hsetlik/ESP808/Schematic/Clap.kicad_sch

## KiCad design Schematic/Clap.kicad_sch (2023-09-09)

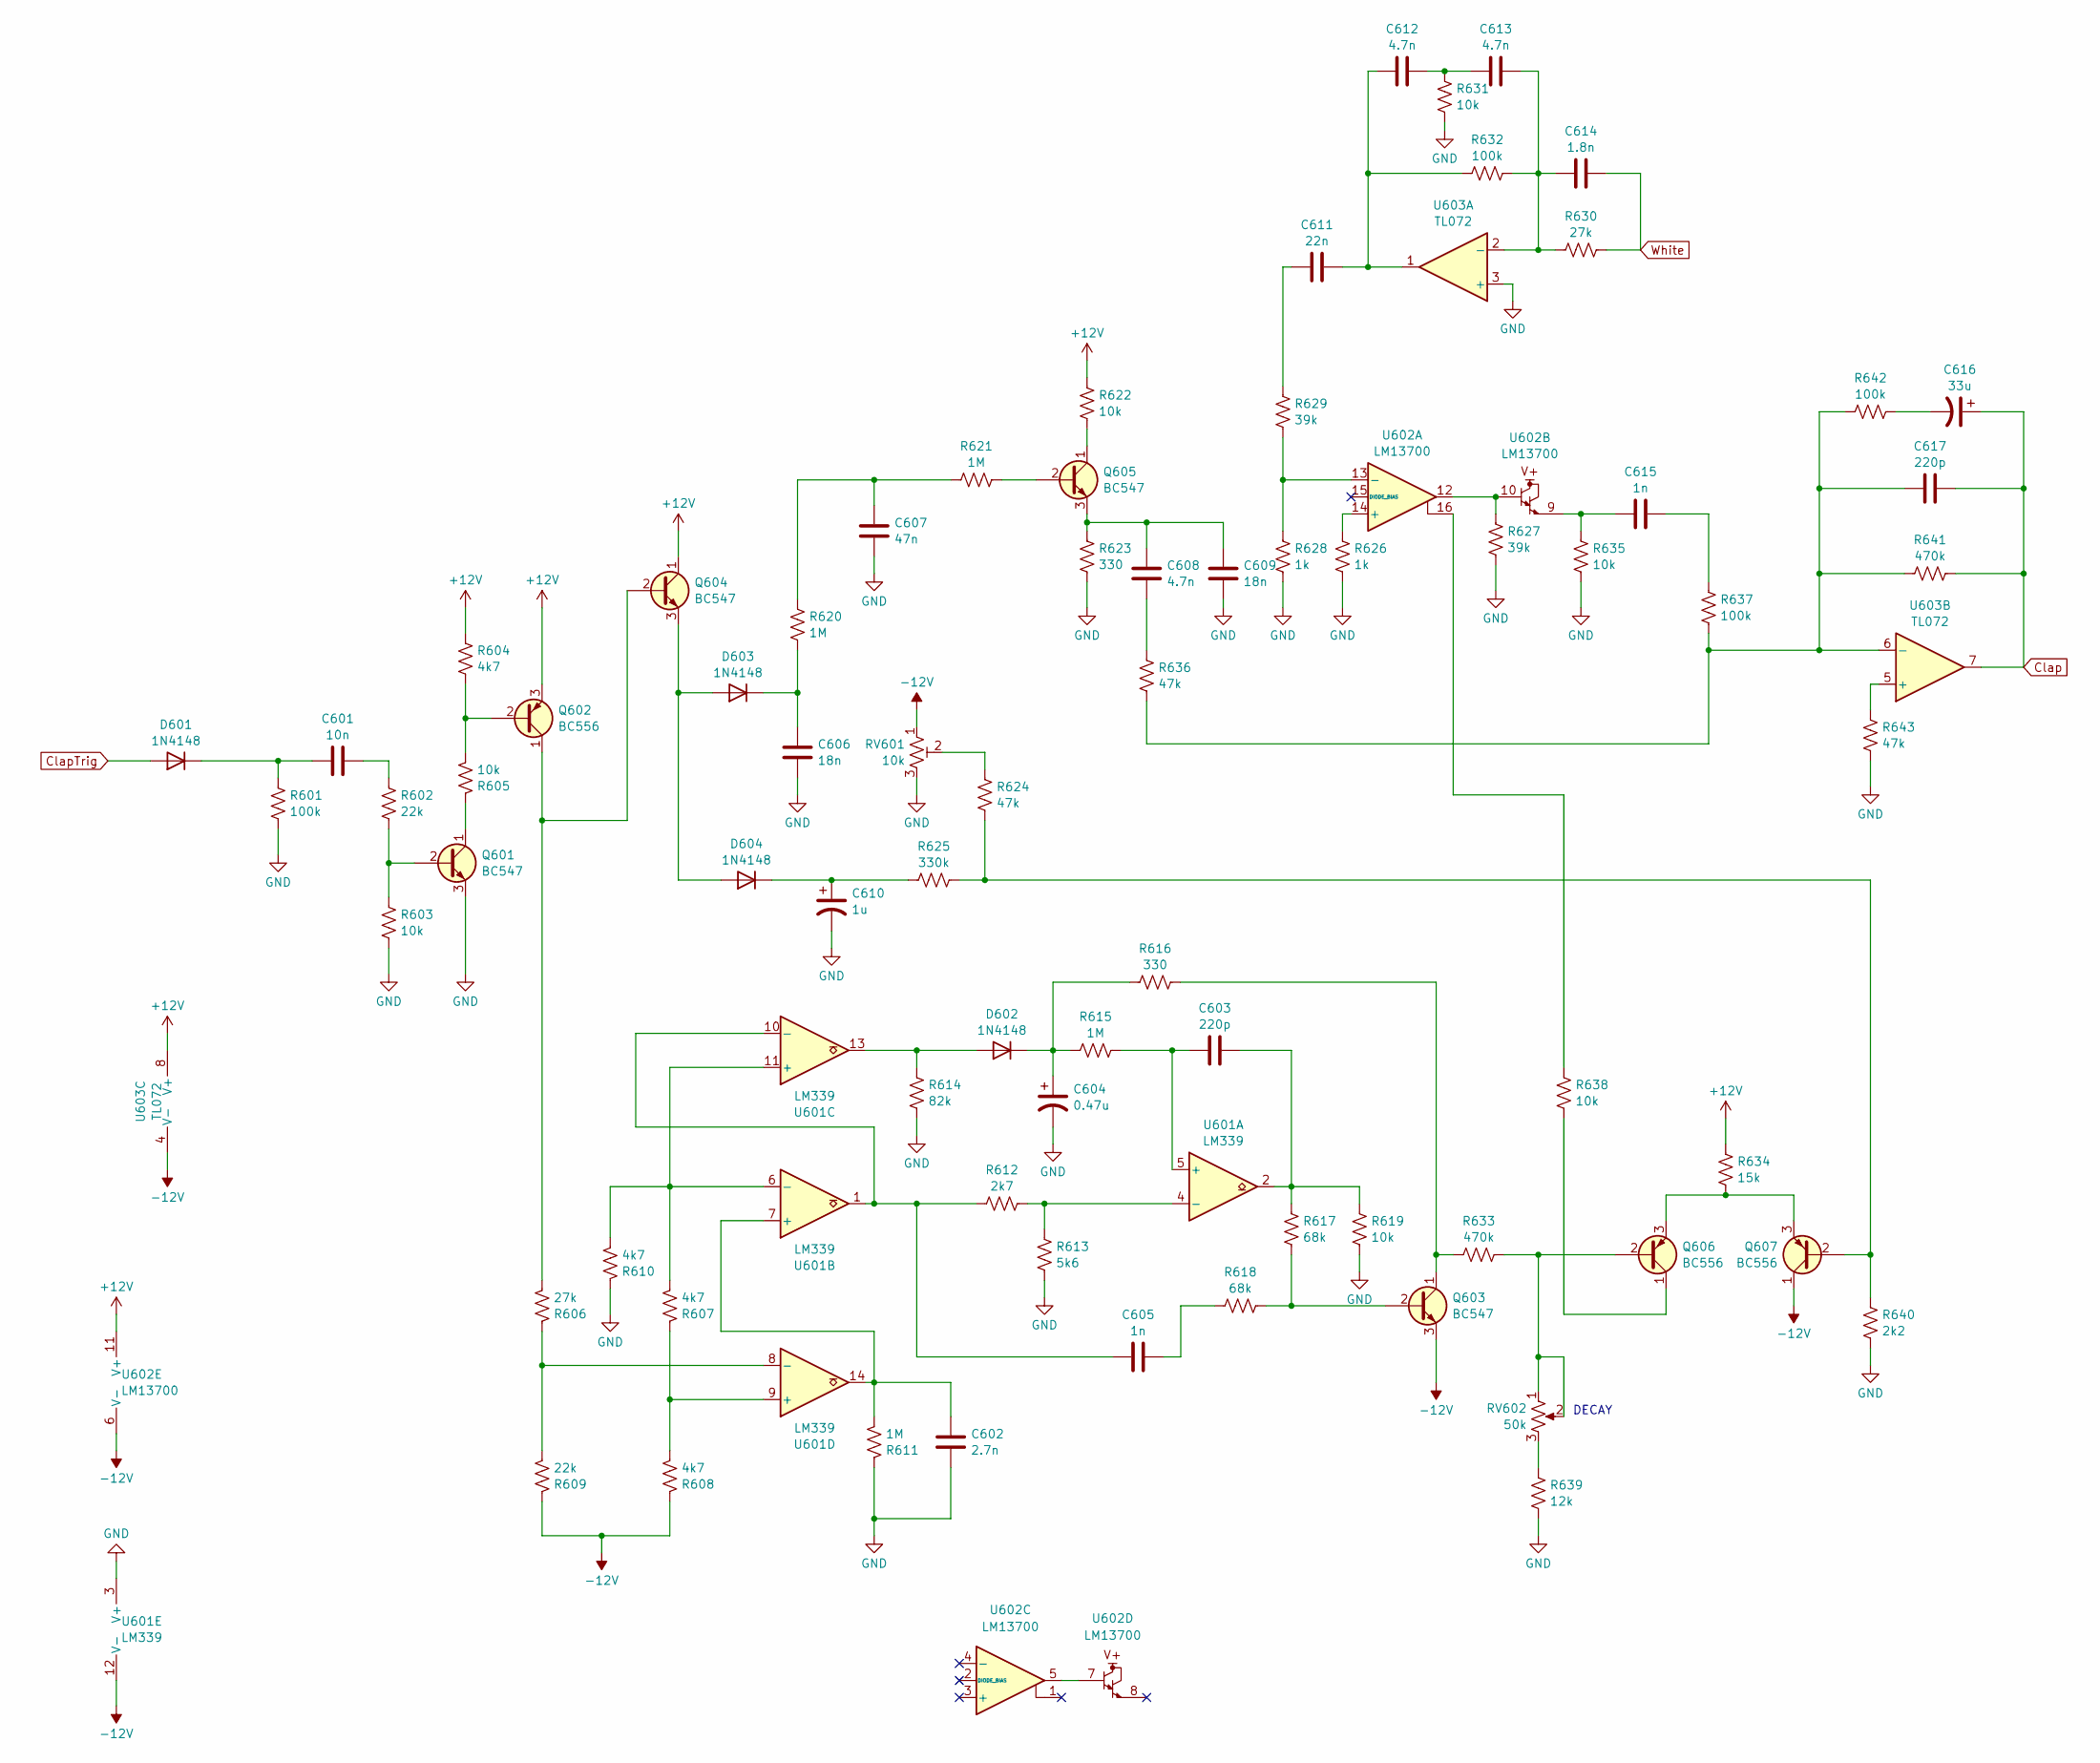
[picture p1: schematic Clap.kicad_sch]

Parts:
C601: 10n; C_Disc_D4.7mm_W2.5mm_P5.00mm
C602: 2.7n; C_Disc_D4.7mm_W2.5mm_P5.00mm
C603, C617: 220p; C_Disc_D4.7mm_W2.5mm_P5.00mm
C604: 0.47u; CP_Radial_D5.0mm_P2.00mm
C605, C615: 1n; C_Disc_D4.7mm_W2.5mm_P5.00mm
C606, C609: 18n; C_Disc_D4.7mm_W2.5mm_P5.00mm
C607: 47n; C_Disc_D4.7mm_W2.5mm_P5.00mm
C608, C612, C613: 4.7n; C_Disc_D4.7mm_W2.5mm_P5.00mm
C610: 1u; CP_Radial_D5.0mm_P2.00mm
C611: 22n; C_Disc_D4.7mm_W2.5mm_P5.00mm
C614: 1.8n; C_Disc_D4.7mm_W2.5mm_P5.00mm
C616: 33u; CP_Radial_D6.3mm_P2.50mm
D601, D602, D603, D604: 1N4148; D_DO-35_SOD27_P7.62mm_Horizontal
Q601, Q603, Q604, Q605: BC547; TO-92L_HandSolder
Q602, Q606, Q607: BC556; TO-92L_HandSolder
R601, R632, R637, R642: 100k; R_Axial_DIN0207_L6.3mm_D2.5mm_P7.62mm_Horizontal
R602, R609: 22k; R_Axial_DIN0207_L6.3mm_D2.5mm_P7.62mm_Horizontal
R603, R605, R619, R622, R631, R635, R638: 10k; R_Axial_DIN0207_L6.3mm_D2.5mm_P7.62mm_Horizontal
R604, R607, R608, R610: 4k7; R_Axial_DIN0207_L6.3mm_D2.5mm_P7.62mm_Horizontal
R606, R630: 27k; R_Axial_DIN0207_L6.3mm_D2.5mm_P7.62mm_Horizontal
R611, R615, R620, R621: 1M; R_Axial_DIN0207_L6.3mm_D2.5mm_P7.62mm_Horizontal
R612: 2k7; R_Axial_DIN0207_L6.3mm_D2.5mm_P7.62mm_Horizontal
R613: 5k6; R_Axial_DIN0207_L6.3mm_D2.5mm_P7.62mm_Horizontal
R614: 82k; R_Axial_DIN0207_L6.3mm_D2.5mm_P7.62mm_Horizontal
R616, R623: 330; R_Axial_DIN0207_L6.3mm_D2.5mm_P7.62mm_Horizontal
R617, R618: 68k; R_Axial_DIN0207_L6.3mm_D2.5mm_P7.62mm_Horizontal
R624, R636, R643: 47k; R_Axial_DIN0207_L6.3mm_D2.5mm_P7.62mm_Horizontal
R625: 330k; R_Axial_DIN0207_L6.3mm_D2.5mm_P7.62mm_Horizontal
R626, R628: 1k; R_Axial_DIN0207_L6.3mm_D2.5mm_P7.62mm_Horizontal
R627, R629: 39k; R_Axial_DIN0207_L6.3mm_D2.5mm_P7.62mm_Horizontal
R633, R641: 470k; R_Axial_DIN0207_L6.3mm_D2.5mm_P7.62mm_Horizontal
R634: 15k; R_Axial_DIN0207_L6.3mm_D2.5mm_P7.62mm_Horizontal
R639: 12k; R_Axial_DIN0207_L6.3mm_D2.5mm_P7.62mm_Horizontal
R640: 2k2; R_Axial_DIN0207_L6.3mm_D2.5mm_P7.62mm_Horizontal
RV601: 10k; Potentiometer_Piher_PT-6-V_Vertical
RV602: 50k; PinHeader_1x03_P2.54mm_Vertical
U601: LM339; DIP-14_W7.62mm
U602: LM13700; DIP-16_W7.62mm
U603: TL072; DIP-8_W7.62mm

Connections:
+12V: Q602.3 (E), Q604.1 (C), R604.1, R622.1, R634.2, U602.11 (V+), U603.8 (V+)
-12V: Q603.3 (E), Q607.1 (C), R608.1, R609.1, RV601.1, U601.12 (V-), U602.6 (V-), U603.4 (V-)
Clap: C616.1, C617.2, R641.2, U603.7
ClapTrig: D601.2 (A)
GND: C602.2, C604.2, C606.2, C607.2, C609.2, C610.2, Q601.3 (E), R601.2, R603.2, R610.1, R611.1, R613.1, R614.1, R619.1, R623.2, R626.2, R627.2, R628.2, R631.2, R635.2, R639.1, R640.1, R643.2, RV601.3, U601.3 (V+), U603.3 (+)
unnamed: C601.1, D601.1 (K), R601.1
unnamed: C601.2, R602.1
unnamed: C602.1, R611.2, U601.7 (+), U601.14
unnamed: C603.1, R617.2, R619.2, U601.2
unnamed: C603.2, R615.1, U601.5 (+)
unnamed: C604.1, D602.1 (K), R615.2, R616.2
unnamed: C605.1, R618.2
unnamed: C605.2, R612.1, U601.1, U601.10 (-)
unnamed: C606.1, D603.1 (K), R620.2
unnamed: C607.1, R620.1, R621.1
unnamed: C608.1, C609.1, Q605.3 (E), R623.1
unnamed: C608.2, R636.1
unnamed: C610.1, D604.1 (K), R625.1
unnamed: C611.1, R629.1
unnamed: C611.2, C612.1, R632.1, U603.1
unnamed: C612.2, C613.1, R631.1
unnamed: C613.2, C614.1, R630.1, R632.2, U603.2 (-)
unnamed: C615.1, R635.1, U602.9
unnamed: C615.2, R637.1
unnamed: C616.2, R642.2
unnamed: C617.1, R636.2, R637.2, R641.1, R642.1, U603.6 (-)
unnamed: D602.2 (A), R614.2, U601.13
unnamed: D603.2 (A), D604.2 (A), Q604.3 (E)
unnamed: Q601.1 (C), R605.1
unnamed: Q601.2 (B), R602.2, R603.1
unnamed: Q602.1 (C), Q604.2 (B), R606.2
unnamed: Q602.2 (B), R604.2, R605.2
unnamed: Q603.1 (C), R616.1, R633.2
unnamed: Q603.2 (B), R617.1, R618.1
unnamed: Q605.1 (C), R622.2
unnamed: Q605.2 (B), R621.2
unnamed: Q606.1 (C), R638.2
unnamed: Q606.2 (B), R633.1, RV602.1, RV602.2
unnamed: Q606.3 (E), Q607.3 (E), R634.1
unnamed: Q607.2 (B), R624.2, R625.2, R640.2
unnamed: R606.1, R609.2, U601.8 (-)
unnamed: R607.1, R608.2, U601.9 (+)
unnamed: R607.2, R610.2, U601.6 (-), U601.11 (+)
unnamed: R612.2, R613.2, U601.4 (-)
unnamed: R624.1, RV601.2
unnamed: R626.1, U602.14 (+)
unnamed: R627.1, U602.10, U602.12
unnamed: R628.1, R629.2, U602.13 (-)
unnamed: R638.1, U602.16
unnamed: R639.2, RV602.3
unnamed: R643.1, U603.5 (+)
unnamed: U602.5, U602.7
White: C614.2, R630.2

Notes on the sheet:
DECAY
