hsetlik/ESP808/Schematic/Clave.kicad_sch

## KiCad design Schematic/Clave.kicad_sch (2023-09-09)

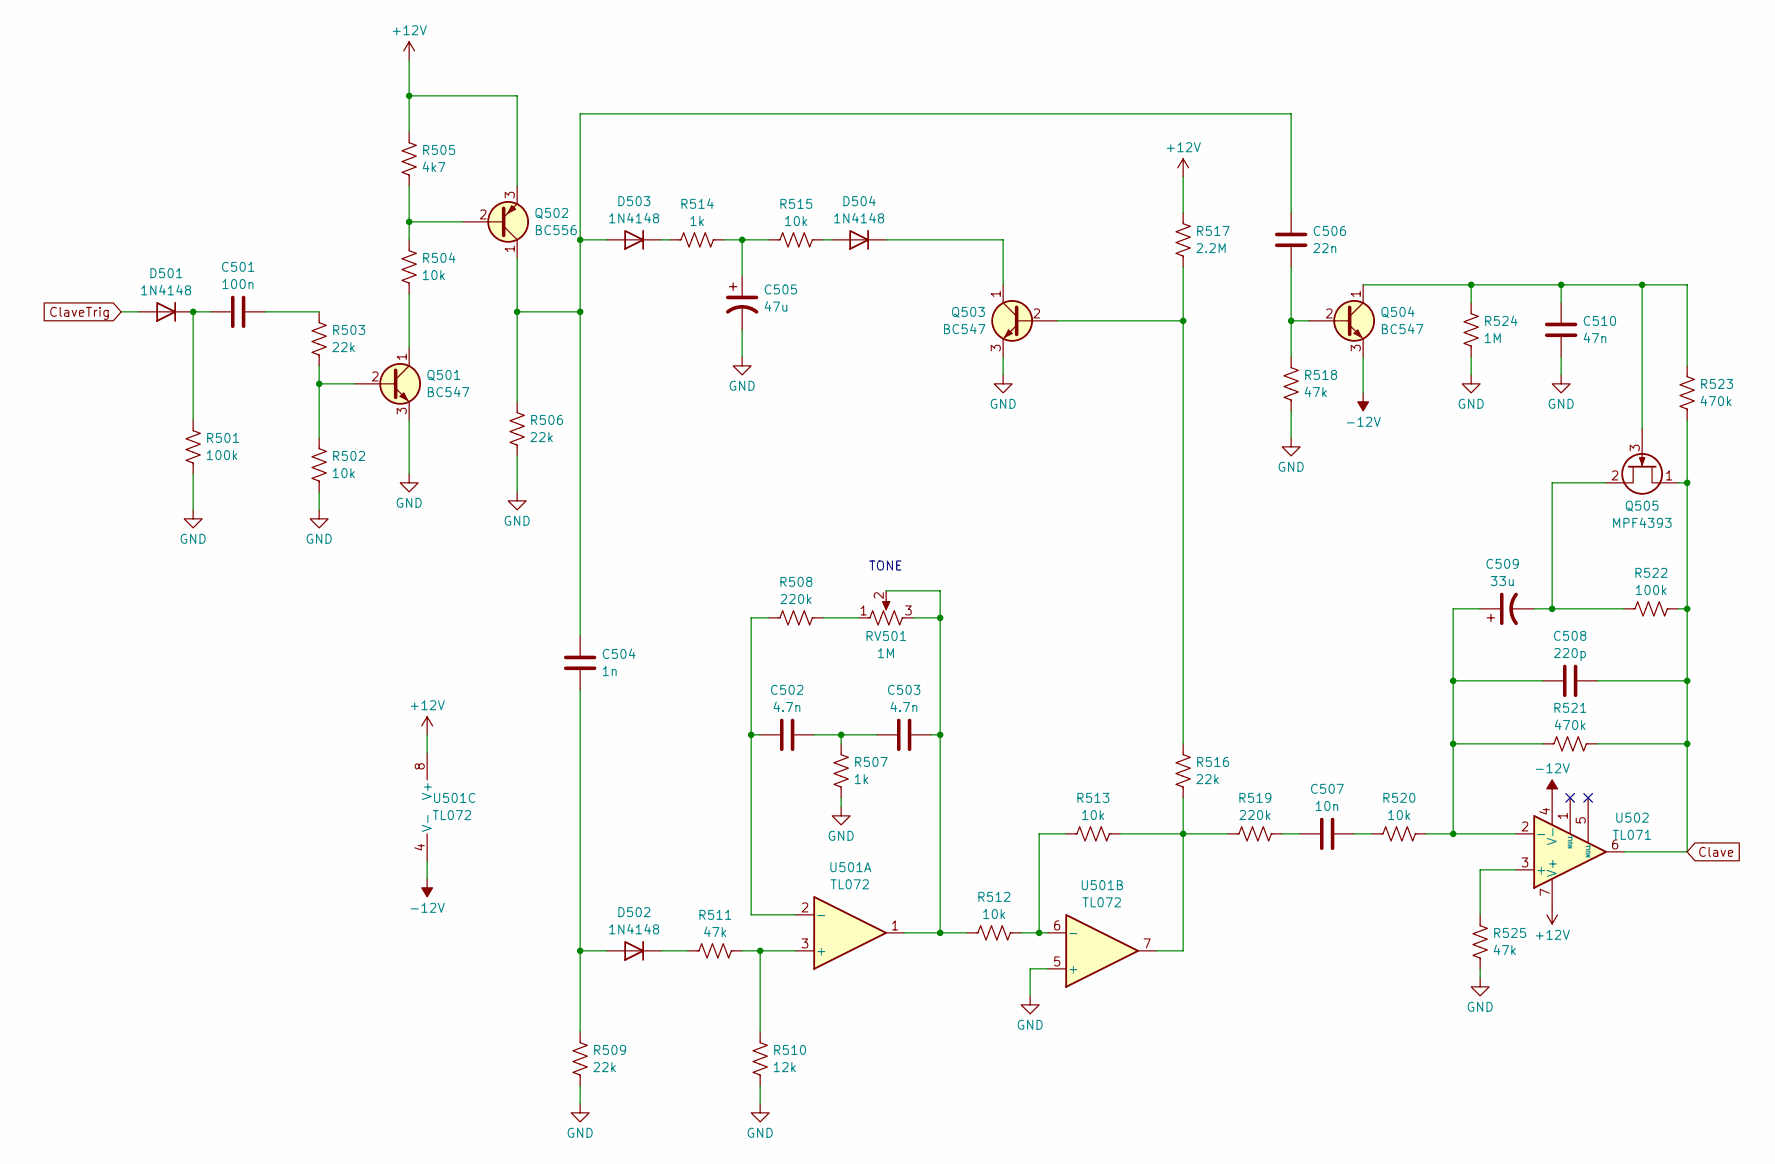
[picture p2: schematic Clave.kicad_sch]

Parts:
C501: 100n; C_Disc_D4.7mm_W2.5mm_P5.00mm
C502, C503: 4.7n; C_Disc_D4.7mm_W2.5mm_P5.00mm
C504: 1n; C_Disc_D4.7mm_W2.5mm_P5.00mm
C505: 47u; CP_Radial_D6.3mm_P2.50mm
C506: 22n; C_Disc_D4.7mm_W2.5mm_P5.00mm
C507: 10n; C_Disc_D4.7mm_W2.5mm_P5.00mm
C508: 220p; C_Disc_D4.7mm_W2.5mm_P5.00mm
C509: 33u; CP_Radial_D6.3mm_P2.50mm
C510: 47n; C_Disc_D4.7mm_W2.5mm_P5.00mm
D501, D502, D503, D504: 1N4148; D_DO-35_SOD27_P7.62mm_Horizontal
Q501, Q503, Q504: BC547; TO-92L_HandSolder
Q502: BC556; TO-92L_HandSolder
Q505: MPF4393; TO-92L_HandSolder
R501, R522: 100k; R_Axial_DIN0207_L6.3mm_D2.5mm_P7.62mm_Horizontal
R502, R504, R512, R513, R515, R520: 10k; R_Axial_DIN0207_L6.3mm_D2.5mm_P7.62mm_Horizontal
R503, R506, R509, R516: 22k; R_Axial_DIN0207_L6.3mm_D2.5mm_P7.62mm_Horizontal
R505: 4k7; R_Axial_DIN0207_L6.3mm_D2.5mm_P7.62mm_Horizontal
R507, R514: 1k; R_Axial_DIN0207_L6.3mm_D2.5mm_P7.62mm_Horizontal
R508, R519: 220k; R_Axial_DIN0207_L6.3mm_D2.5mm_P7.62mm_Horizontal
R510: 12k; R_Axial_DIN0207_L6.3mm_D2.5mm_P7.62mm_Horizontal
R511, R518, R525: 47k; R_Axial_DIN0207_L6.3mm_D2.5mm_P7.62mm_Horizontal
R517: 2.2M; R_Axial_DIN0207_L6.3mm_D2.5mm_P7.62mm_Horizontal
R521, R523: 470k; R_Axial_DIN0207_L6.3mm_D2.5mm_P7.62mm_Horizontal
R524: 1M; R_Axial_DIN0207_L6.3mm_D2.5mm_P7.62mm_Horizontal
RV501: 1M; PinHeader_1x03_P2.54mm_Vertical
U501: TL072; DIP-8_W7.62mm
U502: TL071; DIP-8_W7.62mm

Connections:
+12V: Q502.3 (E), R505.1, R517.2, U501.8 (V+), U502.7 (V+)
-12V: Q504.3 (E), U501.4 (V-), U502.4 (V-)
Clave: C508.2, Q505.1 (D), R521.2, R522.2, R523.2, U502.6
ClaveTrig: D501.2 (A)
GND: C505.2, C510.2, Q501.3 (E), Q503.3 (E), R501.2, R502.2, R506.2, R507.2, R509.1, R510.1, R518.1, R524.2, R525.1, U501.5 (+)
unnamed: C501.1, D501.1 (K), R501.1
unnamed: C501.2, R503.1
unnamed: C502.1, R508.1, U501.2 (-)
unnamed: C502.2, C503.1, R507.1
unnamed: C503.2, R512.1, RV501.2, RV501.3, U501.1
unnamed: C504.1, C506.1, D503.2 (A), Q502.1 (C), R506.1
unnamed: C504.2, D502.2 (A), R509.2
unnamed: C505.1, R514.2, R515.1
unnamed: C506.2, Q504.2 (B), R518.2
unnamed: C507.1, R519.2
unnamed: C507.2, R520.1
unnamed: C508.1, C509.1, R520.2, R521.1, U502.2 (-)
unnamed: C509.2, Q505.2 (S), R522.1
unnamed: C510.1, Q504.1 (C), Q505.3 (G), R523.1, R524.1
unnamed: D502.1 (K), R511.2
unnamed: D503.1 (K), R514.1
unnamed: D504.1 (K), Q503.1 (C)
unnamed: D504.2 (A), R515.2
unnamed: Q501.1 (C), R504.2
unnamed: Q501.2 (B), R502.1, R503.2
unnamed: Q502.2 (B), R504.1, R505.2
unnamed: Q503.2 (B), R516.2, R517.1
unnamed: R508.2, RV501.1
unnamed: R510.2, R511.1, U501.3 (+)
unnamed: R512.2, R513.1, U501.6 (-)
unnamed: R513.2, R516.1, R519.1, U501.7
unnamed: R525.2, U502.3 (+)

Notes on the sheet:
TONE
