hsetlik/ESP808/Schematic/Digital.kicad_sch

## KiCad design Schematic/Digital.kicad_sch (2023-11-16)

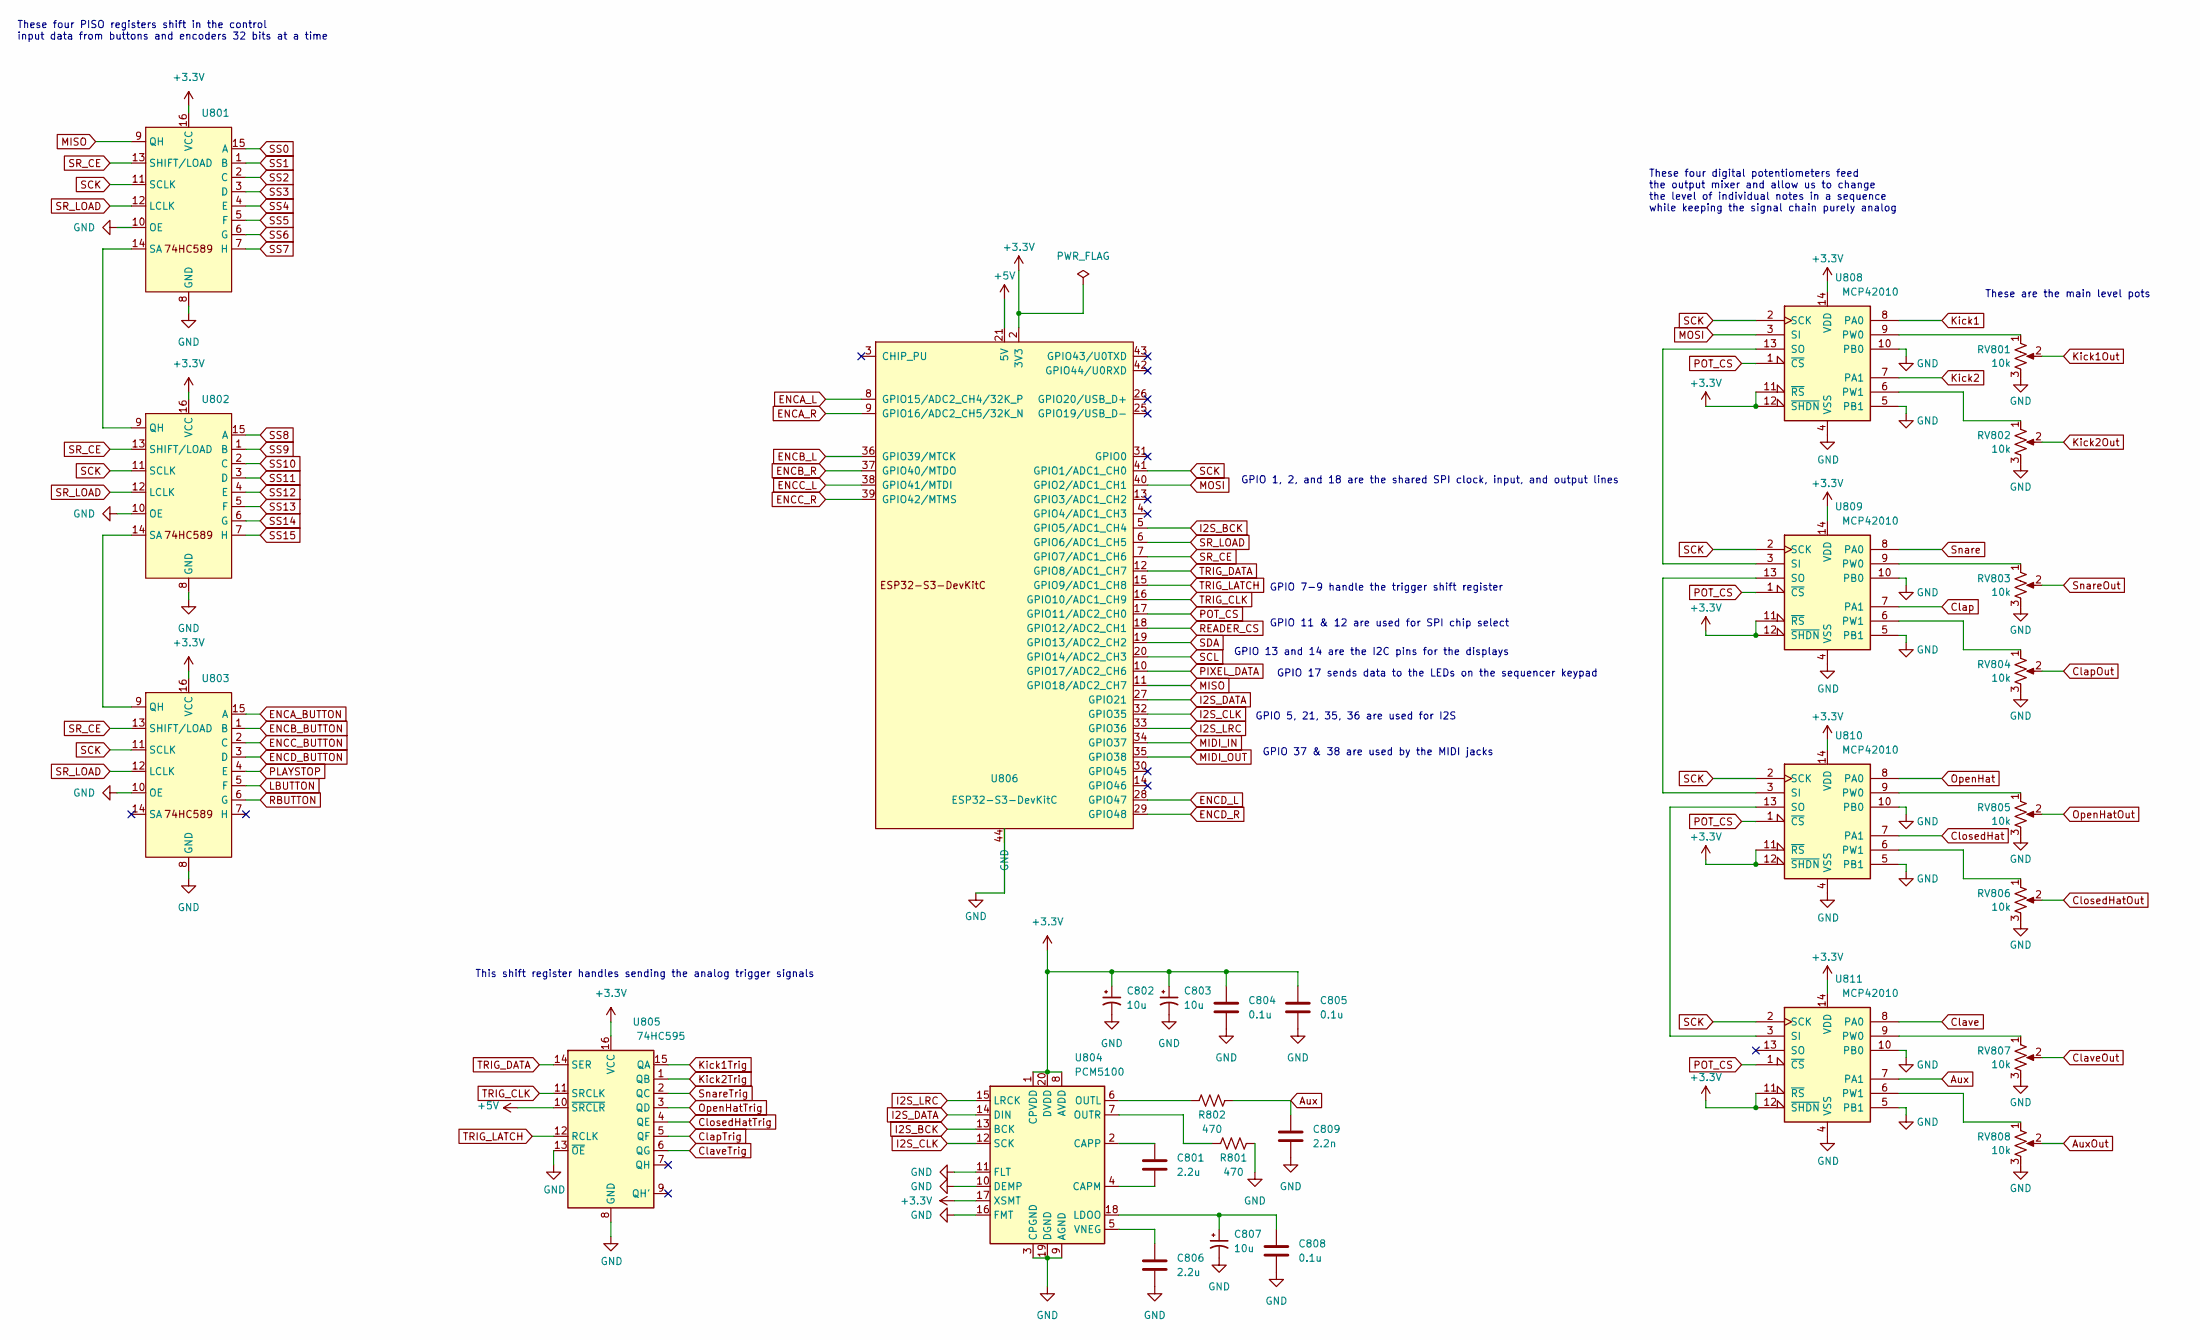
[picture p3: schematic Digital.kicad_sch]

Parts:
C801, C806: 2.2u; C_Disc_D4.7mm_W2.5mm_P5.00mm
C802, C803, C807: 10u; CP_Radial_D5.0mm_P2.00mm
C804, C805, C808: 0.1u; C_Disc_D4.7mm_W2.5mm_P5.00mm
C809: 2.2n; C_Disc_D4.7mm_W2.5mm_P5.00mm
R801, R802: 470; R_Axial_DIN0207_L6.3mm_D2.5mm_P7.62mm_Horizontal
RV801, RV802, RV803, RV804, RV805, RV806, RV807, RV808: 10k; PinHeader_1x03_P2.54mm_Vertical
U801, U802, U803: SO-16_3.9x9.9mm_P1.27mm
U804: PCM5100; TSSOP-20_4.4x6.5mm_P0.65mm
U805: 74HC595; DIP-16_W7.62mm
U806: ESP32-S3-DevKitC
U808, U809, U810, U811: MCP42010; DIP-14_W7.62mm

Connections:
+3.3V: C802.1, C803.1, C804.1, C805.1, U801.16 (VCC), U802.16 (VCC), U803.16 (VCC), U804.1 (CPVDD), U804.8 (AVDD), U804.17 (XSMT), U804.20 (DVDD), U805.16 (VCC), U806.1 (3V3), U806.2 (3V3), U808.11 (~RS), U808.12 (~SHDN), U808.14 (VDD), U809.11 (~RS), U809.12 (~SHDN), U809.14 (VDD), U810.11 (~RS), U810.12 (~SHDN), U810.14 (VDD), U811.11 (~RS), U811.12 (~SHDN), U811.14 (VDD)
+5V: U805.10 (~SRCLR), U806.21 (5V)
Aux: C809.1, R802.2, U811.7 (PA1)
AuxOut: RV808.2
Clap: U809.7 (PA1)
ClapOut: RV804.2
ClapTrig: U805.5 (QF)
Clave: U811.8 (PA0)
ClaveOut: RV807.2
ClaveTrig: U805.6 (QG)
ClosedHat: U810.7 (PA1)
ClosedHatOut: RV806.2
ClosedHatTrig: U805.4 (QE)
ENCA_BUTTON: U803.15 (A)
ENCA_L: U806.8 (GPIO15/ADC2_CH4/32K_P)
ENCA_R: U806.9 (GPIO16/ADC2_CH5/32K_N)
ENCB_BUTTON: U803.1 (B)
ENCB_L: U806.36 (GPIO39/MTCK)
ENCB_R: U806.37 (GPIO40/MTDO)
ENCC_BUTTON: U803.2 (C)
ENCC_L: U806.38 (GPIO41/MTDI)
ENCC_R: U806.39 (GPIO42/MTMS)
ENCD_BUTTON: U803.3 (D)
ENCD_L: U806.28 (GPIO47)
ENCD_R: U806.29 (GPIO48)
GND: C802.2, C803.2, C804.2, C805.2, C806.2, C807.2, C808.2, C809.2, R801.2, RV801.3, RV802.3, RV803.3, RV804.3, RV805.3, RV806.3, RV807.3, RV808.3, U801.8 (GND), U801.10 (OE), U802.8 (GND), U802.10 (OE), U803.8 (GND), U803.10 (OE), U804.3 (CPGND), U804.9 (AGND), U804.10 (DEMP), U804.11 (FLT), U804.16 (FMT), U804.19 (DGND), U805.8 (GND), U805.13 (~OE), U806.22 (GND), U806.23 (GND), U806.24 (GND), U806.44 (GND), U808.4 (VSS), U808.5 (PB1), U808.10 (PB0), U809.4 (VSS), U809.5 (PB1), U809.10 (PB0), U810.4 (VSS), U810.5 (PB1), U810.10 (PB0), U811.4 (VSS), U811.5 (PB1), U811.10 (PB0)
I2S_BCK: U804.13 (BCK), U806.5 (GPIO5/ADC1_CH4)
I2S_CLK: U804.12 (SCK), U806.32 (GPIO35)
I2S_DATA: U804.14 (DIN), U806.27 (GPIO21)
I2S_LRC: U804.15 (LRCK), U806.33 (GPIO36)
Kick1: U808.8 (PA0)
Kick1Out: RV801.2
Kick1Trig: U805.15 (QA)
Kick2: U808.7 (PA1)
Kick2Out: RV802.2
Kick2Trig: U805.1 (QB)
LBUTTON: U803.5 (F)
MIDI_IN: U806.34 (GPIO37)
MIDI_OUT: U806.35 (GPIO38)
MISO: U801.9 (QH), U806.11 (GPIO18/ADC2_CH7)
MOSI: U806.40 (GPIO2/ADC1_CH1), U808.3 (SI)
unnamed: C801.1, U804.2 (CAPP)
unnamed: C801.2, U804.4 (CAPM)
unnamed: C806.1, U804.5 (VNEG)
unnamed: C807.1, C808.1, U804.18 (LDOO)
unnamed: R801.1, U804.7 (OUTR)
unnamed: R802.1, U804.6 (OUTL)
unnamed: RV801.1, U808.9 (PW0)
unnamed: RV802.1, U808.6 (PW1)
unnamed: RV803.1, U809.9 (PW0)
unnamed: RV804.1, U809.6 (PW1)
unnamed: RV805.1, U810.9 (PW0)
unnamed: RV806.1, U810.6 (PW1)
unnamed: RV807.1, U811.9 (PW0)
unnamed: RV808.1, U811.6 (PW1)
unnamed: U801.14 (SA), U802.9 (QH)
unnamed: U802.14 (SA), U803.9 (QH)
unnamed: U808.13 (SO), U809.3 (SI)
unnamed: U809.13 (SO), U810.3 (SI)
unnamed: U810.13 (SO), U811.3 (SI)
OpenHat: U810.8 (PA0)
OpenHatOut: RV805.2
OpenHatTrig: U805.3 (QD)
PIXEL_DATA: U806.10 (GPIO17/ADC2_CH6)
PLAYSTOP: U803.4 (E)
POT_CS: U806.17 (GPIO11/ADC2_CH0), U808.1 (~CS), U809.1 (~CS), U810.1 (~CS), U811.1 (~CS)
RBUTTON: U803.6 (G)
READER_CS: U806.18 (GPIO12/ADC2_CH1)
SCK: U801.11 (SCLK), U802.11 (SCLK), U803.11 (SCLK), U806.41 (GPIO1/ADC1_CH0), U808.2 (SCK), U809.2 (SCK), U810.2 (SCK), U811.2 (SCK)
SCL: U806.20 (GPIO14/ADC2_CH3)
SDA: U806.19 (GPIO13/ADC2_CH2)
SR_CE: U801.13 (SHIFT/LOAD), U802.13 (SHIFT/LOAD), U803.13 (SHIFT/LOAD), U806.7 (GPIO7/ADC1_CH6)
SR_LOAD: U801.12 (LCLK), U802.12 (LCLK), U803.12 (LCLK), U806.6 (GPIO6/ADC1_CH5)
SS0: U801.15 (A)
SS1: U801.1 (B)
SS2: U801.2 (C)
SS3: U801.3 (D)
SS4: U801.4 (E)
SS5: U801.5 (F)
SS6: U801.6 (G)
SS7: U801.7 (H)
SS8: U802.15 (A)
SS9: U802.1 (B)
SS10: U802.2 (C)
SS11: U802.3 (D)
SS12: U802.4 (E)
SS13: U802.5 (F)
SS14: U802.6 (G)
SS15: U802.7 (H)
Snare: U809.8 (PA0)
SnareOut: RV803.2
SnareTrig: U805.2 (QC)
TRIG_CLK: U805.11 (SRCLK), U806.16 (GPIO10/ADC1_CH9)
TRIG_DATA: U805.14 (SER), U806.12 (GPIO8/ADC1_CH7)
TRIG_LATCH: U805.12 (RCLK), U806.15 (GPIO9/ADC1_CH8)

Notes on the sheet:
GPIO 37 & 38 are used by the MIDI jacks
GPIO 11 & 12 are used for SPI chip select
GPIO 5, 21, 35, 36 are used for I2S
GPIO 1, 2, and 18 are the shared SPI clock, input, and output lines
These four PISO registers shift in the control input data from buttons and encoders 32 bits at a time
GPIO 17 sends data to the LEDs on the sequencer keypad
This shift register handles sending the analog trigger signals
These four digital potentiometers feed the output mixer and allow us to change the level of individual notes in a sequence while keeping the signal chain purely analog
These are the main level pots
GPIO 13 and 14 are the I2C pins for the displays
GPIO 7-9 handle the trigger shift register
