hsetlik/ESP808/Schematic/HiHat.kicad_sch

## KiCad design Schematic/HiHat.kicad_sch (2023-11-11)

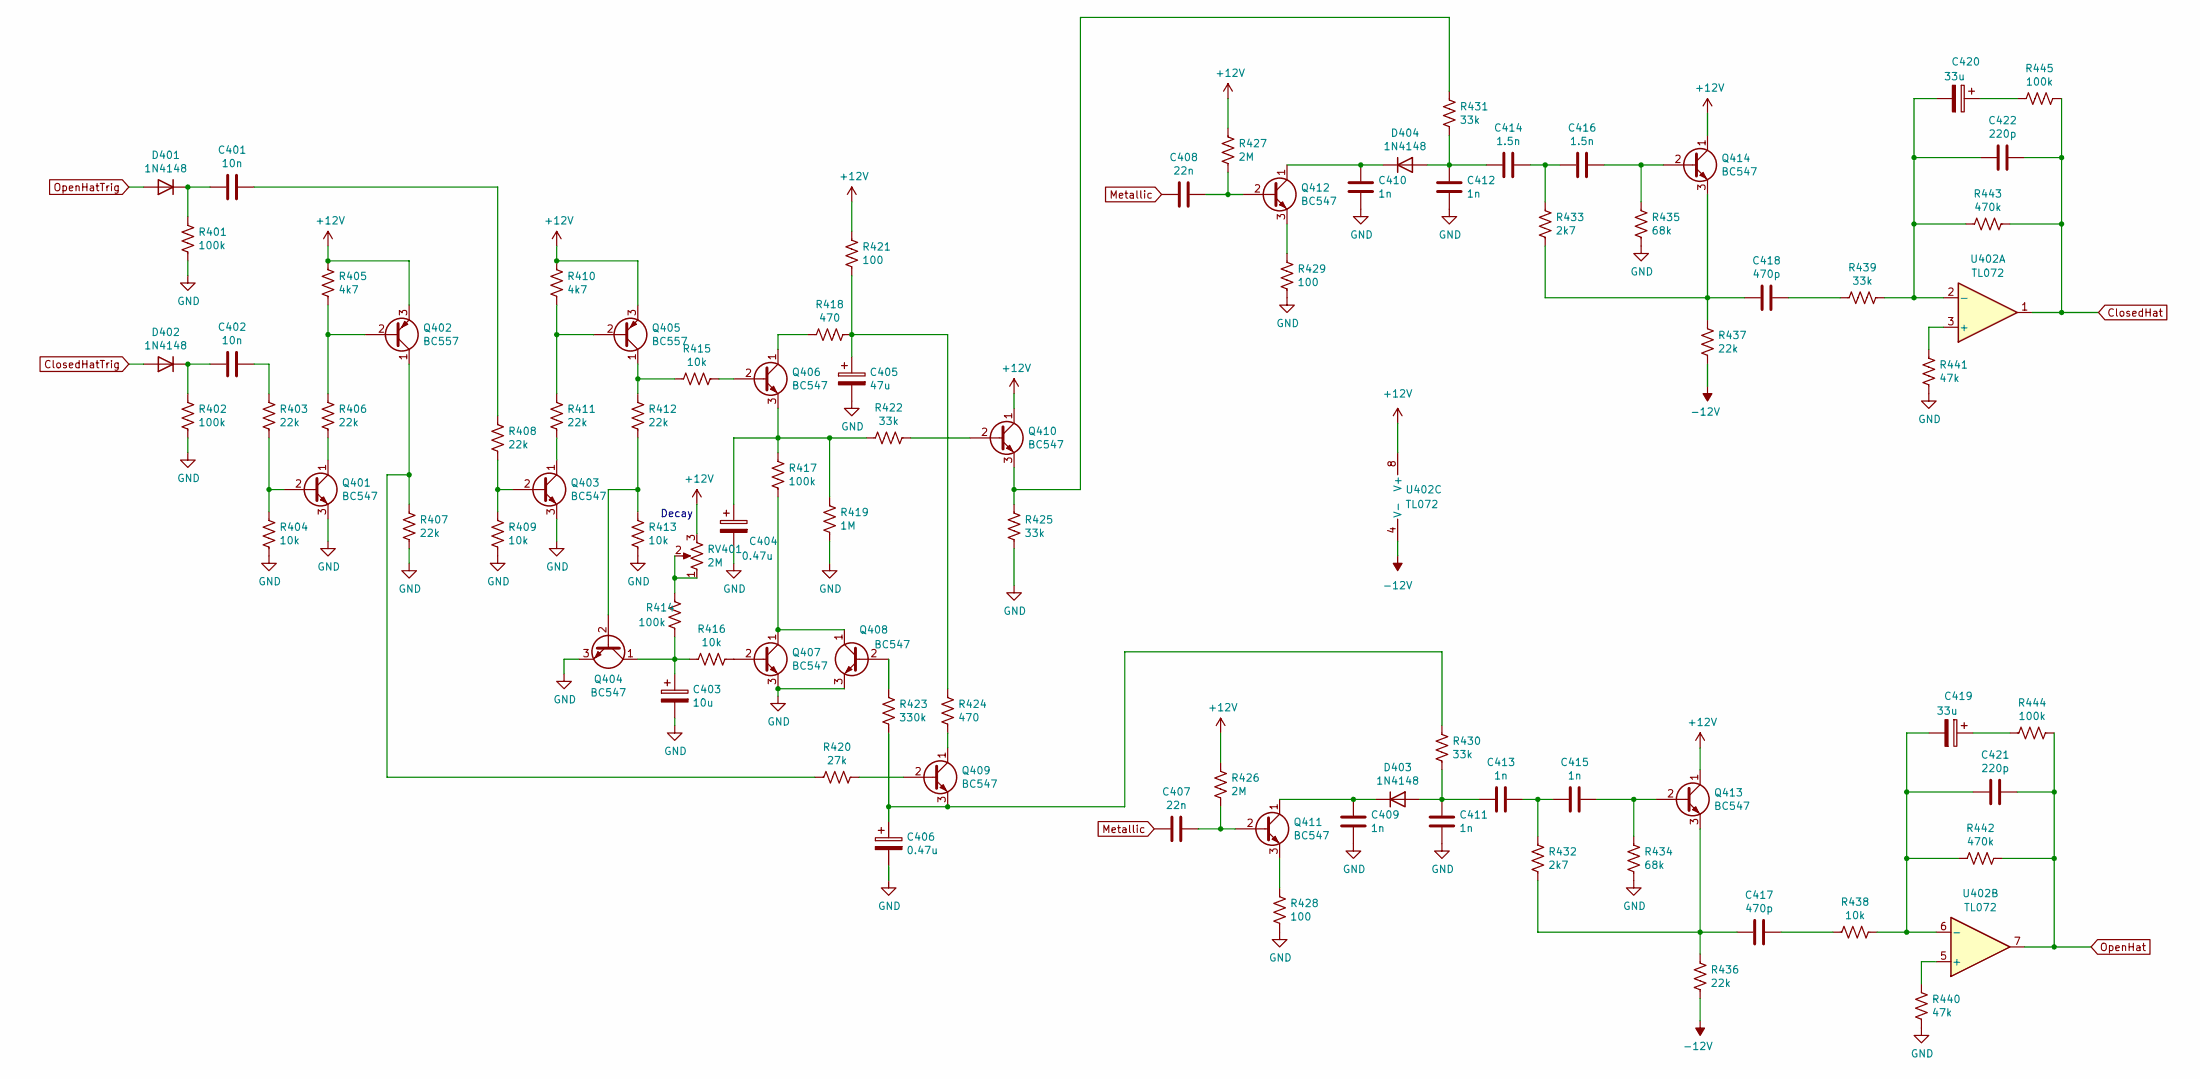
[picture p4: schematic HiHat.kicad_sch]

Parts:
C401, C402: 10n; C_Disc_D4.7mm_W2.5mm_P5.00mm
C403: 10u; CP_Radial_D6.3mm_P2.50mm
C404, C406: 0.47u; CP_Radial_D5.0mm_P2.00mm
C405: 47u; CP_Radial_D6.3mm_P2.50mm
C407, C408: 22n; C_Disc_D4.7mm_W2.5mm_P5.00mm
C409, C410, C411, C412, C413, C415: 1n; C_Disc_D4.7mm_W2.5mm_P5.00mm
C414, C416: 1.5n; C_Disc_D4.7mm_W2.5mm_P5.00mm
C417, C418: 470p; C_Disc_D4.7mm_W2.5mm_P5.00mm
C419, C420: 33u; CP_Radial_D6.3mm_P2.50mm
C421, C422: 220p; C_Disc_D4.7mm_W2.5mm_P5.00mm
D401, D402, D403, D404: 1N4148; D_DO-35_SOD27_P7.62mm_Horizontal
Q401, Q403, Q404, Q406, Q407, Q408, Q409, Q410, Q411, Q412, Q413, Q414: BC547; TO-92L_HandSolder
Q402, Q405: BC557; TO-92L_HandSolder
R401, R402, R414, R417, R444, R445: 100k; R_Axial_DIN0207_L6.3mm_D2.5mm_P7.62mm_Horizontal
R403, R406, R407, R408, R411, R412, R436, R437: 22k; R_Axial_DIN0207_L6.3mm_D2.5mm_P7.62mm_Horizontal
R404, R409, R413, R415, R416, R438: 10k; R_Axial_DIN0207_L6.3mm_D2.5mm_P7.62mm_Horizontal
R405, R410: 4k7; R_Axial_DIN0207_L6.3mm_D2.5mm_P7.62mm_Horizontal
R418, R424: 470; R_Axial_DIN0207_L6.3mm_D2.5mm_P7.62mm_Horizontal
R419: 1M; R_Axial_DIN0207_L6.3mm_D2.5mm_P7.62mm_Horizontal
R420: 27k; R_Axial_DIN0207_L6.3mm_D2.5mm_P7.62mm_Horizontal
R421, R428, R429: 100; R_Axial_DIN0207_L6.3mm_D2.5mm_P7.62mm_Horizontal
R422, R425, R430, R431, R439: 33k; R_Axial_DIN0207_L6.3mm_D2.5mm_P7.62mm_Horizontal
R423: 330k; R_Axial_DIN0207_L6.3mm_D2.5mm_P7.62mm_Horizontal
R426, R427: 2M; R_Axial_DIN0207_L6.3mm_D2.5mm_P7.62mm_Horizontal
R432, R433: 2k7; R_Axial_DIN0207_L6.3mm_D2.5mm_P7.62mm_Horizontal
R434, R435: 68k; R_Axial_DIN0207_L6.3mm_D2.5mm_P7.62mm_Horizontal
R440, R441: 47k; R_Axial_DIN0207_L6.3mm_D2.5mm_P7.62mm_Horizontal
R442, R443: 470k; R_Axial_DIN0207_L6.3mm_D2.5mm_P7.62mm_Horizontal
RV401: 2M; PinHeader_1x03_P2.54mm_Vertical
U402: TL072; DIP-8_W7.62mm

Connections:
+12V: Q402.3 (E), Q405.3 (E), Q410.1 (C), Q413.1 (C), Q414.1 (C), R405.1, R410.1, R421.2, R426.1, R427.1, RV401.3, U402.8 (V+)
-12V: R436.2, R437.2, U402.4 (V-)
ClosedHat: C422.2, R443.1, R445.1, U402.1
ClosedHatTrig: D402.2 (A)
GND: C403.2, C404.2, C405.2, C406.2, C409.1, C410.1, C411.1, C412.1, Q401.3 (E), Q403.3 (E), Q404.3 (E), Q407.3 (E), Q408.3 (E), R401.2, R402.2, R404.2, R407.2, R409.2, R413.2, R419.2, R425.1, R428.2, R429.2, R434.2, R435.2, R440.1, R441.1
Metallic: C407.2, C408.2
unnamed: C401.1, R408.1
unnamed: C401.2, D401.1 (K), R401.1
unnamed: C402.1, R403.1
unnamed: C402.2, D402.1 (K), R402.1
unnamed: C403.1, Q404.1 (C), R414.2, R416.2
unnamed: C404.1, Q406.3 (E), R417.1, R419.1, R422.2
unnamed: C405.1, R418.1, R421.1, R424.2
unnamed: C406.1, Q409.3 (E), R423.1, R430.1
unnamed: C407.1, Q411.2 (B), R426.2
unnamed: C408.1, Q412.2 (B), R427.2
unnamed: C409.2, D403.1 (K), Q411.1 (C)
unnamed: C410.2, D404.1 (K), Q412.1 (C)
unnamed: C411.2, C413.1, D403.2 (A), R430.2
unnamed: C412.2, C414.1, D404.2 (A), R431.2
unnamed: C413.2, C415.1, R432.1
unnamed: C414.2, C416.1, R433.1
unnamed: C415.2, Q413.2 (B), R434.1
unnamed: C416.2, Q414.2 (B), R435.1
unnamed: C417.1, Q413.3 (E), R432.2, R436.1
unnamed: C417.2, R438.2
unnamed: C418.1, Q414.3 (E), R433.2, R437.1
unnamed: C418.2, R439.2
unnamed: C419.1, R444.2
unnamed: C419.2, C421.1, R438.1, R442.2, U402.6 (-)
unnamed: C420.1, R445.2
unnamed: C420.2, C422.1, R439.1, R443.2, U402.2 (-)
unnamed: Q401.1 (C), R406.2
unnamed: Q401.2 (B), R403.2, R404.1
unnamed: Q402.1 (C), R407.1, R420.2
unnamed: Q402.2 (B), R405.2, R406.1
unnamed: Q403.1 (C), R411.2
unnamed: Q403.2 (B), R408.2, R409.1
unnamed: Q404.2 (B), R412.2, R413.1
unnamed: Q405.1 (C), R412.1, R415.2
unnamed: Q405.2 (B), R410.2, R411.1
unnamed: Q406.1 (C), R418.2
unnamed: Q406.2 (B), R415.1
unnamed: Q407.1 (C), Q408.1 (C), R417.2
unnamed: Q407.2 (B), R416.1
unnamed: Q408.2 (B), R423.2
unnamed: Q409.1 (C), R424.1
unnamed: Q409.2 (B), R420.1
unnamed: Q410.2 (B), R422.1
unnamed: Q410.3 (E), R425.2, R431.1
unnamed: Q411.3 (E), R428.1
unnamed: Q412.3 (E), R429.1
unnamed: R414.1, RV401.1, RV401.2
unnamed: R440.2, U402.5 (+)
unnamed: R441.2, U402.3 (+)
OpenHat: C421.2, R442.1, R444.1, U402.7
OpenHatTrig: D401.2 (A)

Notes on the sheet:
Decay
