hsetlik/ESP808/Schematic/Kicks.kicad_sch

## KiCad design Schematic/Kicks.kicad_sch (2023-11-11)

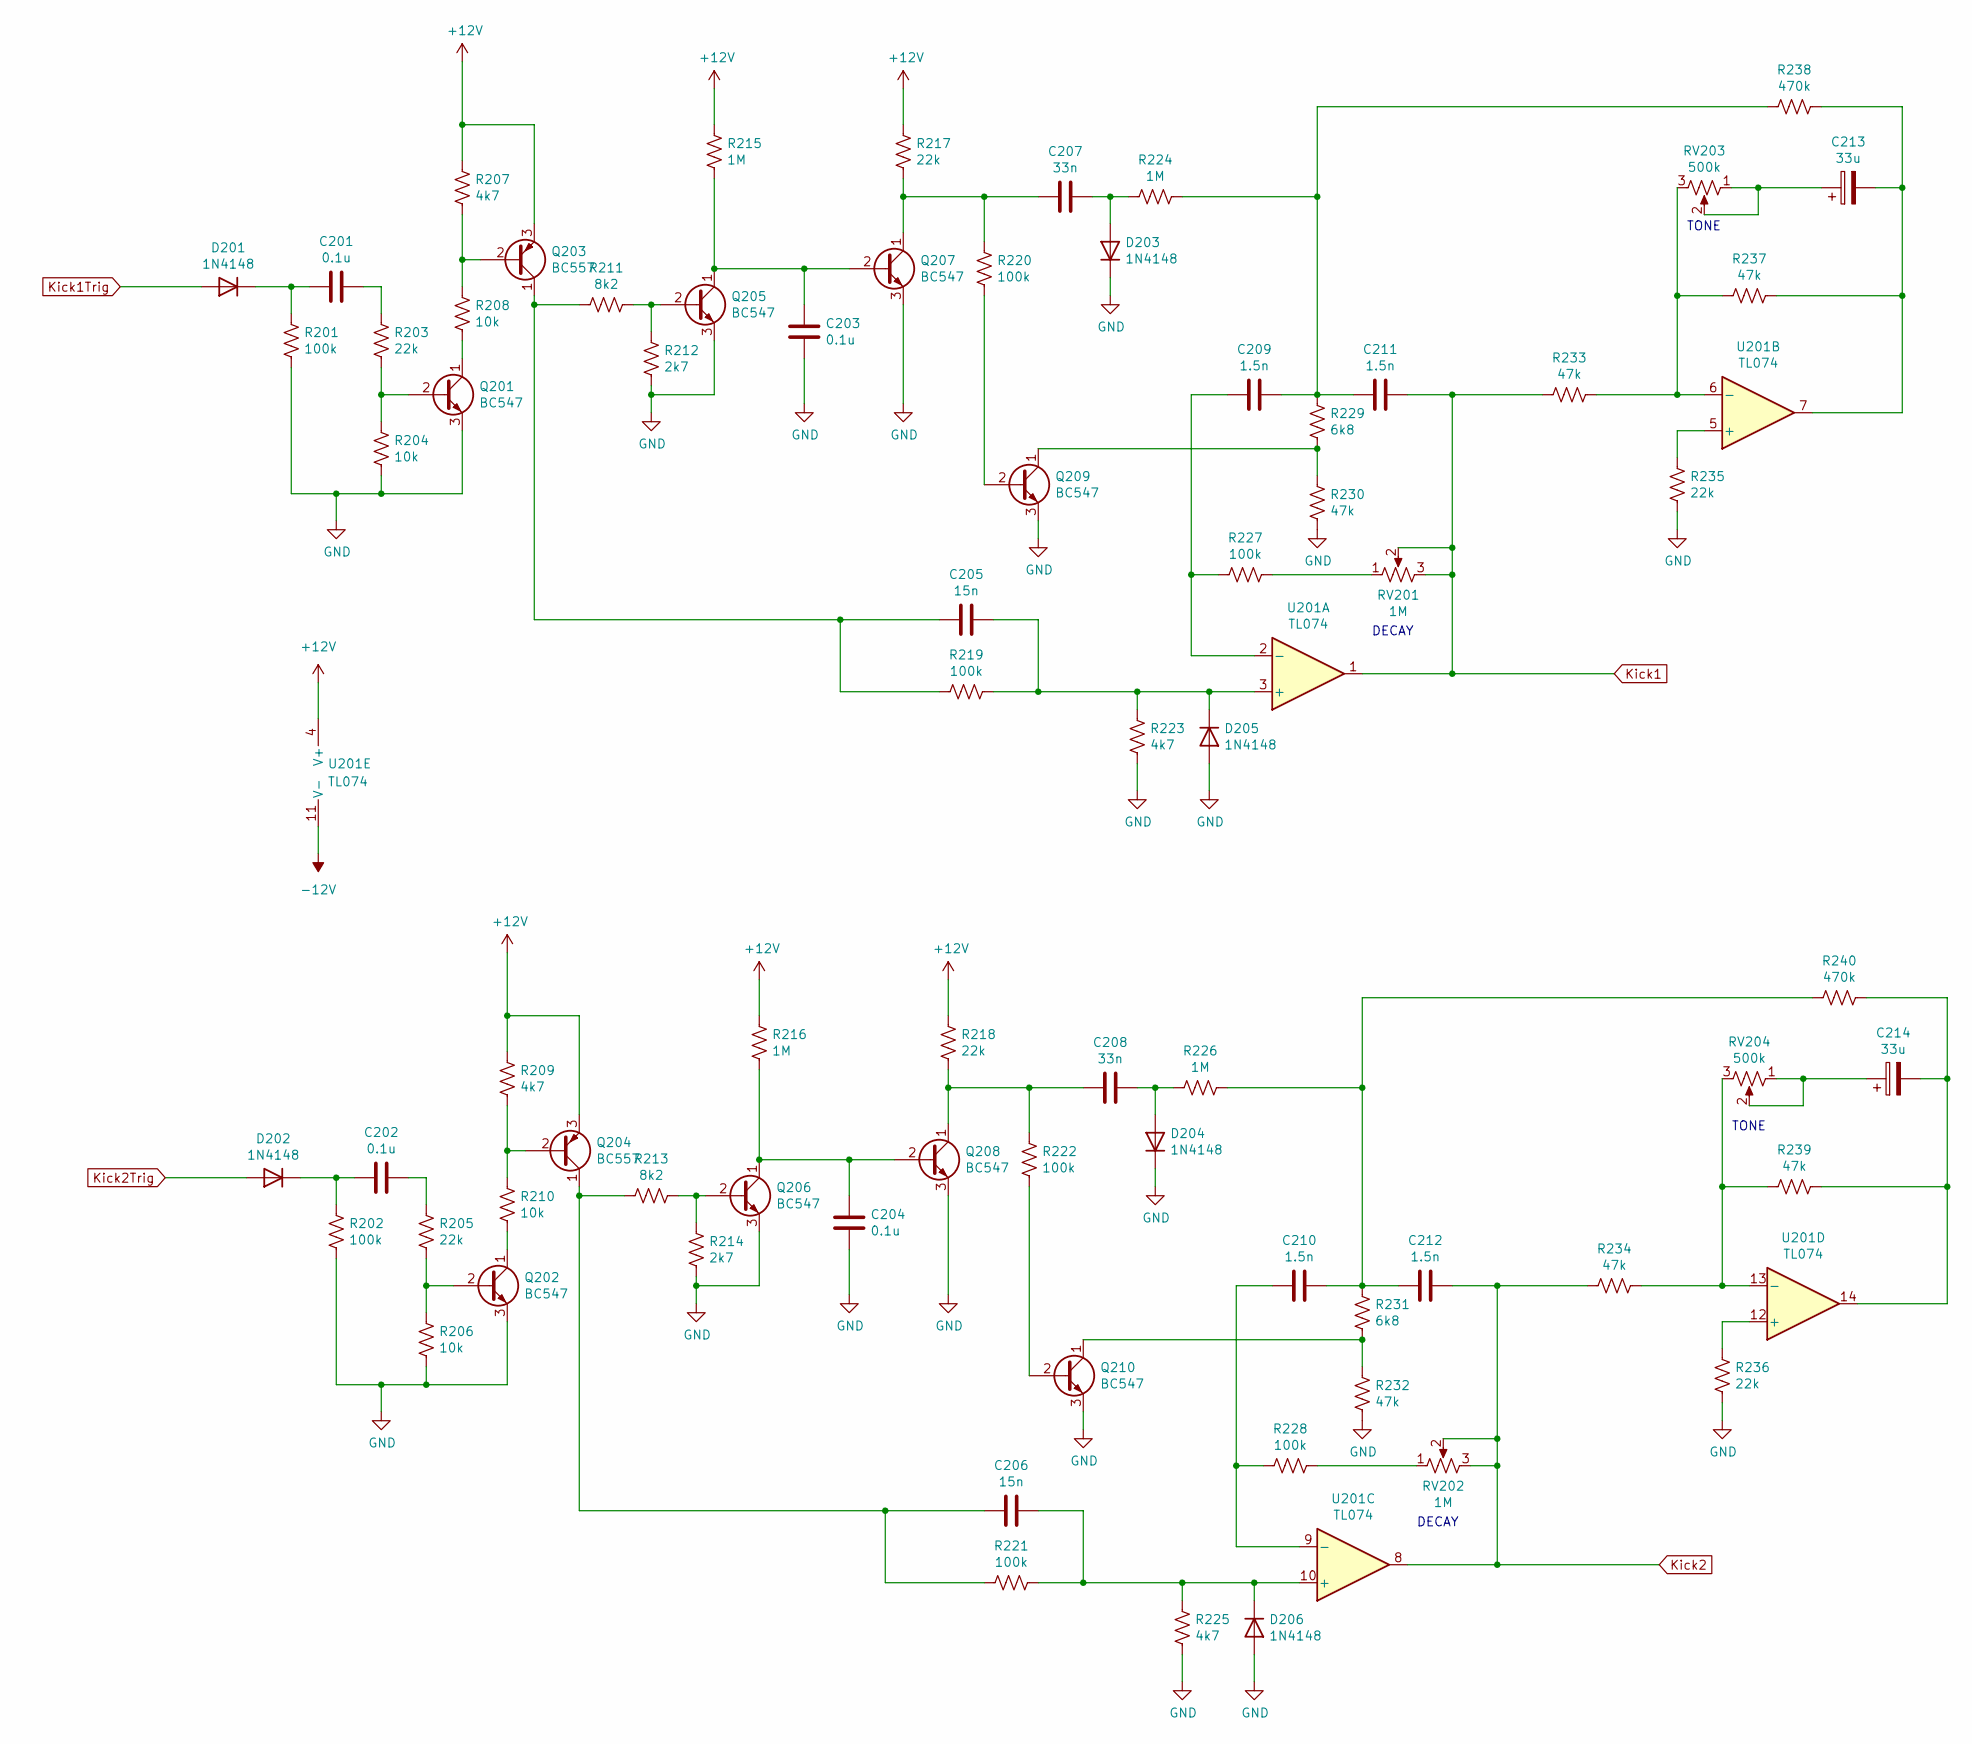
[picture p5: schematic Kicks.kicad_sch]

Parts:
C201, C202, C203, C204: 0.1u; C_Disc_D4.7mm_W2.5mm_P5.00mm
C205, C206: 15n; C_Disc_D4.7mm_W2.5mm_P5.00mm
C207, C208: 33n; C_Disc_D4.7mm_W2.5mm_P5.00mm
C209, C210, C211, C212: 1.5n; C_Disc_D4.7mm_W2.5mm_P5.00mm
C213, C214: 33u; CP_Radial_D6.3mm_P2.50mm
D201, D202, D203, D204, D205, D206: 1N4148; D_DO-35_SOD27_P7.62mm_Horizontal
Q201, Q202, Q205, Q206, Q207, Q208, Q209, Q210: BC547; TO-92L_HandSolder
Q203, Q204: BC557; TO-92L_HandSolder
R201, R202, R219, R220, R221, R222, R227, R228: 100k; R_Axial_DIN0207_L6.3mm_D2.5mm_P7.62mm_Horizontal
R203, R205, R217, R218, R235, R236: 22k; R_Axial_DIN0207_L6.3mm_D2.5mm_P7.62mm_Horizontal
R204, R206, R208, R210: 10k; R_Axial_DIN0207_L6.3mm_D2.5mm_P7.62mm_Horizontal
R207, R209, R223, R225: 4k7; R_Axial_DIN0207_L6.3mm_D2.5mm_P7.62mm_Horizontal
R211, R213: 8k2; R_Axial_DIN0207_L6.3mm_D2.5mm_P7.62mm_Horizontal
R212, R214: 2k7; R_Axial_DIN0207_L6.3mm_D2.5mm_P7.62mm_Horizontal
R215, R216, R224, R226: 1M; R_Axial_DIN0207_L6.3mm_D2.5mm_P7.62mm_Horizontal
R229, R231: 6k8; R_Axial_DIN0207_L6.3mm_D2.5mm_P7.62mm_Horizontal
R230, R232, R233, R234, R237, R239: 47k; R_Axial_DIN0207_L6.3mm_D2.5mm_P7.62mm_Horizontal
R238, R240: 470k; R_Axial_DIN0207_L6.3mm_D2.5mm_P7.62mm_Horizontal
RV201, RV202: 1M; PinHeader_1x03_P2.54mm_Vertical
RV203, RV204: 500k; PinHeader_1x03_P2.54mm_Vertical
U201: TL074; DIP-14_W7.62mm

Connections:
+12V: Q203.3 (E), Q204.3 (E), R207.1, R209.1, R215.1, R216.1, R217.1, R218.1, U201.4 (V+)
-12V: U201.11 (V-)
GND: C203.2, C204.2, D203.1 (K), D204.1 (K), D205.2 (A), D206.2 (A), Q201.3 (E), Q202.3 (E), Q205.3 (E), Q206.3 (E), Q207.3 (E), Q208.3 (E), Q209.3 (E), Q210.3 (E), R201.2, R202.2, R204.2, R206.2, R212.1, R214.1, R223.1, R225.1, R230.1, R232.1, R235.1, R236.1
Kick1: C211.1, R233.2, RV201.2, RV201.3, U201.1
Kick1Trig: D201.2 (A)
Kick2: C212.1, R234.2, RV202.2, RV202.3, U201.8
Kick2Trig: D202.2 (A)
unnamed: C201.1, R203.1
unnamed: C201.2, D201.1 (K), R201.1
unnamed: C202.1, R205.1
unnamed: C202.2, D202.1 (K), R202.1
unnamed: C203.1, Q205.1 (C), Q207.2 (B), R215.2
unnamed: C204.1, Q206.1 (C), Q208.2 (B), R216.2
unnamed: C205.1, D205.1 (K), R219.2, R223.2, U201.3 (+)
unnamed: C205.2, Q203.1 (C), R211.2, R219.1
unnamed: C206.1, D206.1 (K), R221.2, R225.2, U201.10 (+)
unnamed: C206.2, Q204.1 (C), R213.2, R221.1
unnamed: C207.1, D203.2 (A), R224.1
unnamed: C207.2, Q207.1 (C), R217.2, R220.2
unnamed: C208.1, D204.2 (A), R226.1
unnamed: C208.2, Q208.1 (C), R218.2, R222.2
unnamed: C209.1, C211.2, R224.2, R229.2, R238.1
unnamed: C209.2, R227.2, U201.2 (-)
unnamed: C210.1, C212.2, R226.2, R231.2, R240.1
unnamed: C210.2, R228.2, U201.9 (-)
unnamed: C213.1, RV203.1, RV203.2
unnamed: C213.2, R237.2, R238.2, U201.7
unnamed: C214.1, RV204.1, RV204.2
unnamed: C214.2, R239.2, R240.2, U201.14
unnamed: Q201.1 (C), R208.2
unnamed: Q201.2 (B), R203.2, R204.1
unnamed: Q202.1 (C), R210.2
unnamed: Q202.2 (B), R205.2, R206.1
unnamed: Q203.2 (B), R207.2, R208.1
unnamed: Q204.2 (B), R209.2, R210.1
unnamed: Q205.2 (B), R211.1, R212.2
unnamed: Q206.2 (B), R213.1, R214.2
unnamed: Q209.1 (C), R229.1, R230.2
unnamed: Q209.2 (B), R220.1
unnamed: Q210.1 (C), R231.1, R232.2
unnamed: Q210.2 (B), R222.1
unnamed: R227.1, RV201.1
unnamed: R228.1, RV202.1
unnamed: R233.1, R237.1, RV203.3, U201.6 (-)
unnamed: R234.1, R239.1, RV204.3, U201.13 (-)
unnamed: R235.2, U201.5 (+)
unnamed: R236.2, U201.12 (+)

Notes on the sheet:
TONE
DECAY
