hsetlik/ESP808/Schematic/Mixer.kicad_sch

## KiCad design Schematic/Mixer.kicad_sch (2023-11-11)

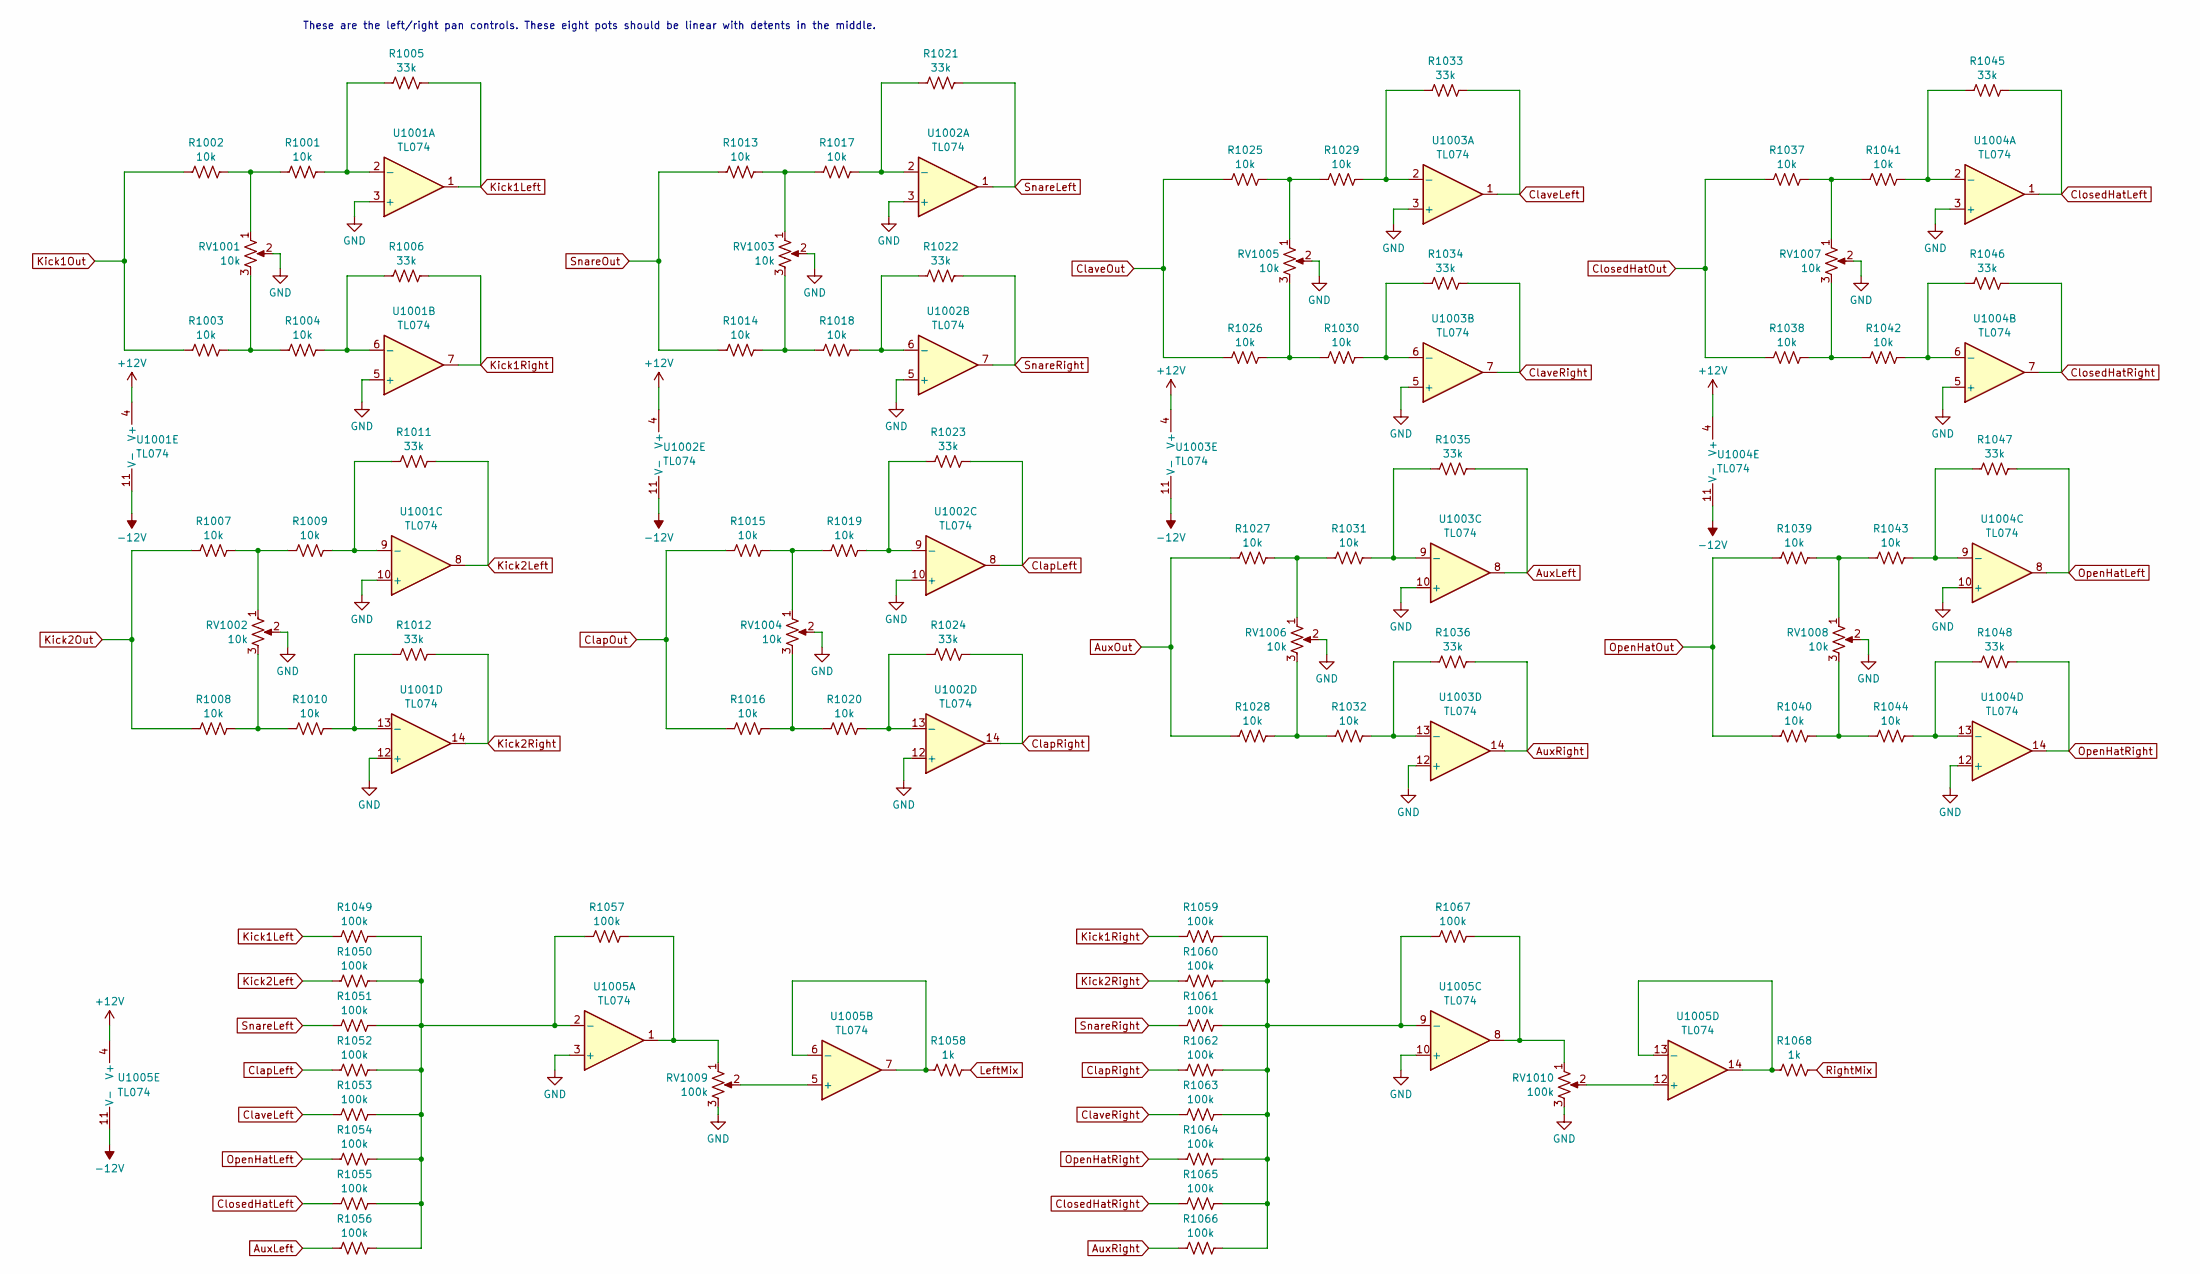
[picture p6: schematic Mixer.kicad_sch]

Parts:
R1001, R1002, R1003, R1004, R1007, R1008, R1009, R1010, R1013, R1014, R1015, R1016, R1017, R1018, R1019, R1020, R1025, R1026, R1027, R1028, R1029, R1030, R1031, R1032, R1037, R1038, R1039, R1040, R1041, R1042, R1043, R1044: 10k; R_Axial_DIN0207_L6.3mm_D2.5mm_P7.62mm_Horizontal
R1005, R1006, R1011, R1012, R1021, R1022, R1023, R1024, R1033, R1034, R1035, R1036, R1045, R1046, R1047, R1048: 33k; R_Axial_DIN0207_L6.3mm_D2.5mm_P2.54mm_Vertical
R1049, R1050, R1051, R1052, R1053, R1054, R1055, R1056, R1059, R1060, R1061, R1062, R1063, R1064, R1065, R1066: 100k; R_Axial_DIN0207_L6.3mm_D2.5mm_P7.62mm_Horizontal
R1057, R1067: 100k; R_Axial_DIN0207_L6.3mm_D2.5mm_P2.54mm_Vertical
R1058, R1068: 1k; R_Axial_DIN0207_L6.3mm_D2.5mm_P7.62mm_Horizontal
RV1001, RV1002, RV1003, RV1004, RV1005, RV1006, RV1007, RV1008: 10k; PinHeader_1x03_P2.54mm_Vertical
RV1009, RV1010: 100k; PinHeader_1x03_P2.54mm_Vertical
U1001, U1002, U1003, U1004, U1005: TL074; DIP-14_W7.62mm

Connections:
+12V: U1001.4 (V+), U1002.4 (V+), U1003.4 (V+), U1004.4 (V+), U1005.4 (V+)
-12V: U1001.11 (V-), U1002.11 (V-), U1003.11 (V-), U1004.11 (V-), U1005.11 (V-)
AuxLeft: R1035.2, R1056.1, U1003.8
AuxOut: R1027.1, R1028.1
AuxRight: R1036.2, R1066.1, U1003.14
ClapLeft: R1023.2, R1052.1, U1002.8
ClapOut: R1015.1, R1016.1
ClapRight: R1024.2, R1062.1, U1002.14
ClaveLeft: R1033.2, R1053.1, U1003.1
ClaveOut: R1025.1, R1026.1
ClaveRight: R1034.2, R1063.1, U1003.7
ClosedHatLeft: R1045.2, R1055.1, U1004.1
ClosedHatOut: R1037.1, R1038.1
ClosedHatRight: R1046.2, R1065.1, U1004.7
GND: RV1001.2, RV1002.2, RV1003.2, RV1004.2, RV1005.2, RV1006.2, RV1007.2, RV1008.2, RV1009.3, RV1010.3, U1001.3 (+), U1001.5 (+), U1001.10 (+), U1001.12 (+), U1002.3 (+), U1002.5 (+), U1002.10 (+), U1002.12 (+), U1003.3 (+), U1003.5 (+), U1003.10 (+), U1003.12 (+), U1004.3 (+), U1004.5 (+), U1004.10 (+), U1004.12 (+), U1005.3 (+), U1005.10 (+)
Kick1Left: R1005.2, R1049.1, U1001.1
Kick1Out: R1002.1, R1003.1
Kick1Right: R1006.2, R1059.1, U1001.7
Kick2Left: R1011.2, R1050.1, U1001.8
Kick2Out: R1007.1, R1008.1
Kick2Right: R1012.2, R1060.1, U1001.14
LeftMix: R1058.2
unnamed: R1001.1, R1002.2, RV1001.1
unnamed: R1001.2, R1005.1, U1001.2 (-)
unnamed: R1003.2, R1004.1, RV1001.3
unnamed: R1004.2, R1006.1, U1001.6 (-)
unnamed: R1007.2, R1009.1, RV1002.1
unnamed: R1008.2, R1010.1, RV1002.3
unnamed: R1009.2, R1011.1, U1001.9 (-)
unnamed: R1010.2, R1012.1, U1001.13 (-)
unnamed: R1013.2, R1017.1, RV1003.1
unnamed: R1014.2, R1018.1, RV1003.3
unnamed: R1015.2, R1019.1, RV1004.1
unnamed: R1016.2, R1020.1, RV1004.3
unnamed: R1017.2, R1021.1, U1002.2 (-)
unnamed: R1018.2, R1022.1, U1002.6 (-)
unnamed: R1019.2, R1023.1, U1002.9 (-)
unnamed: R1020.2, R1024.1, U1002.13 (-)
unnamed: R1025.2, R1029.1, RV1005.1
unnamed: R1026.2, R1030.1, RV1005.3
unnamed: R1027.2, R1031.1, RV1006.1
unnamed: R1028.2, R1032.1, RV1006.3
unnamed: R1029.2, R1033.1, U1003.2 (-)
unnamed: R1030.2, R1034.1, U1003.6 (-)
unnamed: R1031.2, R1035.1, U1003.9 (-)
unnamed: R1032.2, R1036.1, U1003.13 (-)
unnamed: R1037.2, R1041.1, RV1007.1
unnamed: R1038.2, R1042.1, RV1007.3
unnamed: R1039.2, R1043.1, RV1008.1
unnamed: R1040.2, R1044.1, RV1008.3
unnamed: R1041.2, R1045.1, U1004.2 (-)
unnamed: R1042.2, R1046.1, U1004.6 (-)
unnamed: R1043.2, R1047.1, U1004.9 (-)
unnamed: R1044.2, R1048.1, U1004.13 (-)
unnamed: R1049.2, R1050.2, R1051.2, R1052.2, R1053.2, R1054.2, R1055.2, R1056.2, R1057.1, U1005.2 (-)
unnamed: R1057.2, RV1009.1, U1005.1
unnamed: R1058.1, U1005.6 (-), U1005.7
unnamed: R1059.2, R1060.2, R1061.2, R1062.2, R1063.2, R1064.2, R1065.2, R1066.2, R1067.1, U1005.9 (-)
unnamed: R1067.2, RV1010.1, U1005.8
unnamed: R1068.1, U1005.13 (-), U1005.14
unnamed: RV1009.2, U1005.5 (+)
unnamed: RV1010.2, U1005.12 (+)
OpenHatLeft: R1047.2, R1054.1, U1004.8
OpenHatOut: R1039.1, R1040.1
OpenHatRight: R1048.2, R1064.1, U1004.14
RightMix: R1068.2
SnareLeft: R1021.2, R1051.1, U1002.1
SnareOut: R1013.1, R1014.1
SnareRight: R1022.2, R1061.1, U1002.7

Notes on the sheet:
These are the left/right pan controls. These eight pots should be linear with detents in the middle.
