hsetlik/ESP808/Schematic/Noise.kicad_sch

## KiCad design Schematic/Noise.kicad_sch (2023-09-09)

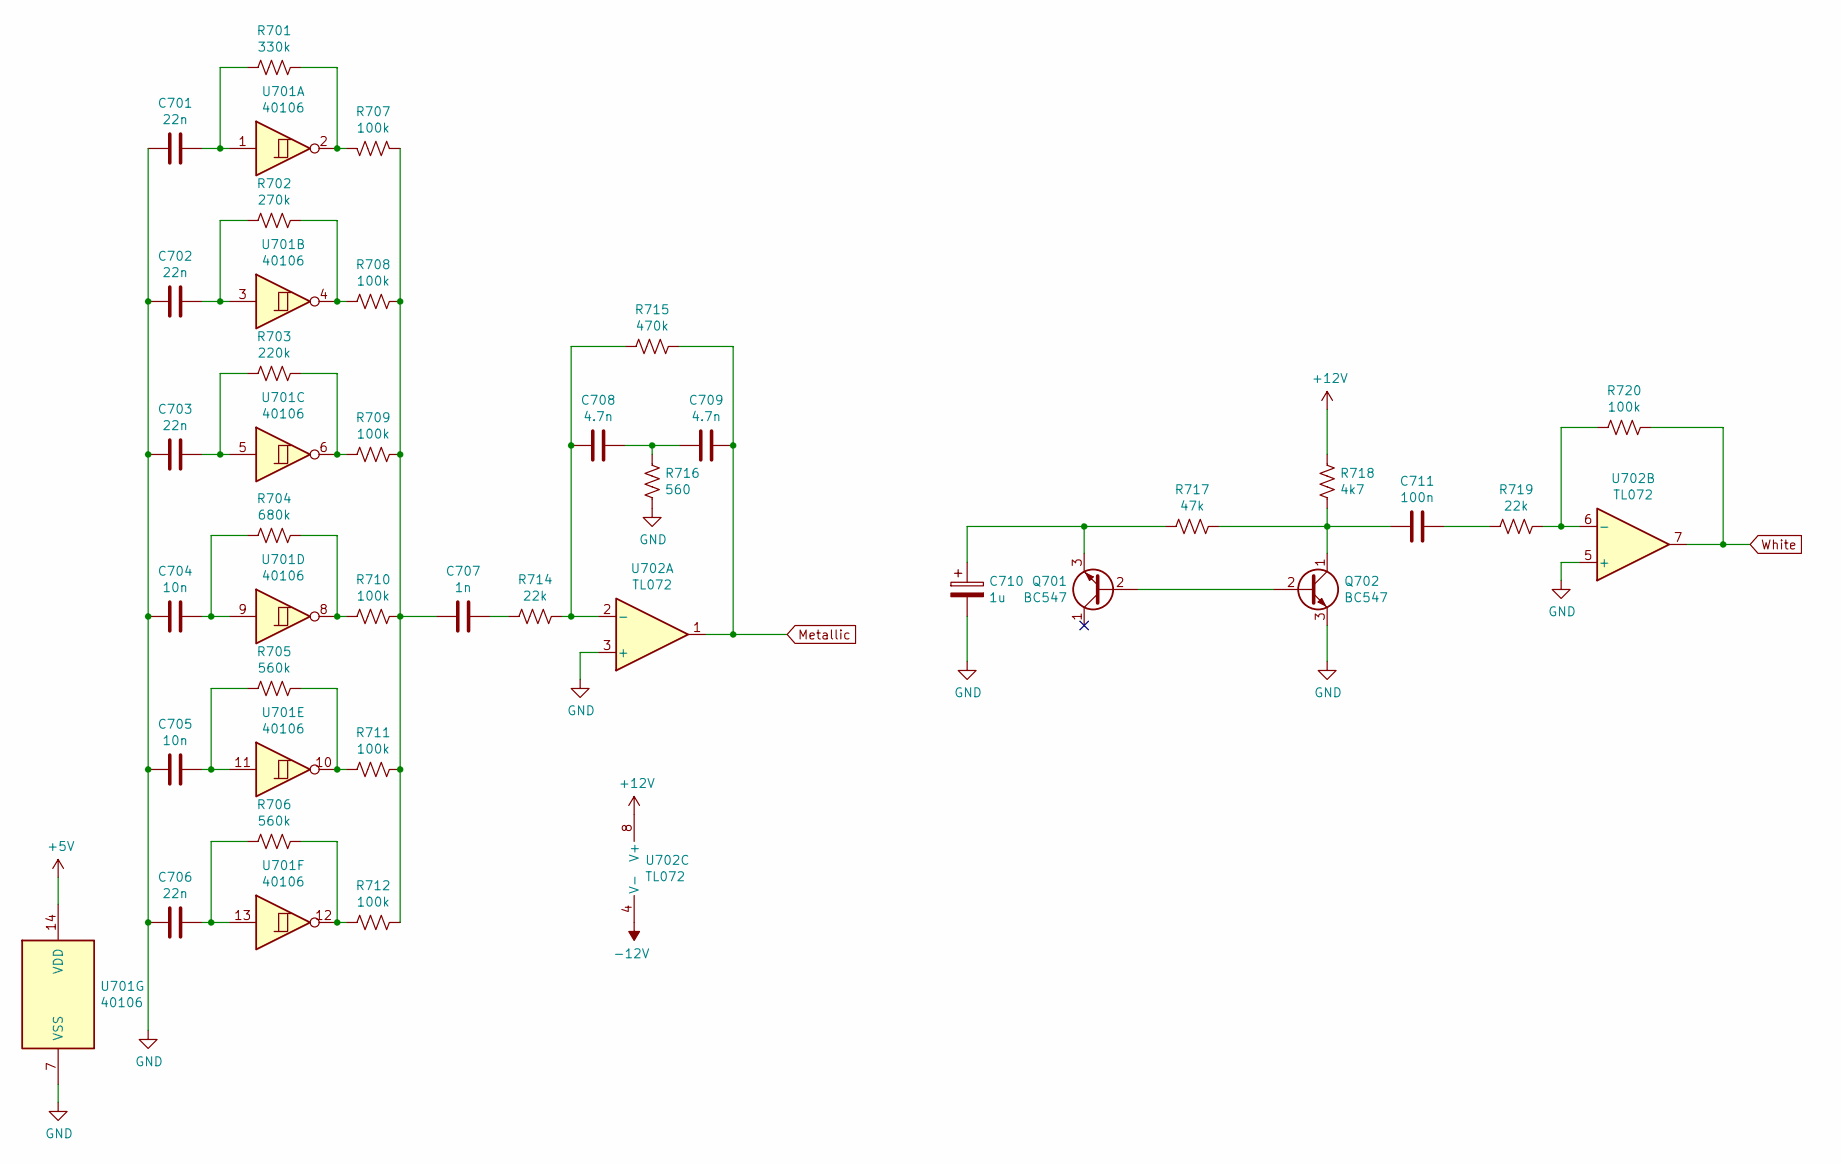
[picture p7: schematic Noise.kicad_sch]

Parts:
C701, C702, C703, C706: 22n; C_Disc_D4.7mm_W2.5mm_P5.00mm
C704, C705: 10n; C_Disc_D4.7mm_W2.5mm_P5.00mm
C707: 1n; C_Disc_D4.7mm_W2.5mm_P5.00mm
C708, C709: 4.7n; C_Disc_D4.7mm_W2.5mm_P5.00mm
C710: 1u; CP_Radial_D4.0mm_P2.00mm
C711: 100n; C_Disc_D4.7mm_W2.5mm_P5.00mm
Q701, Q702: BC547; TO-92L_HandSolder
R701: 330k; R_Axial_DIN0207_L6.3mm_D2.5mm_P2.54mm_Vertical
R702: 270k; R_Axial_DIN0207_L6.3mm_D2.5mm_P2.54mm_Vertical
R703: 220k; R_Axial_DIN0207_L6.3mm_D2.5mm_P2.54mm_Vertical
R704: 680k; R_Axial_DIN0207_L6.3mm_D2.5mm_P2.54mm_Vertical
R705, R706: 560k; R_Axial_DIN0207_L6.3mm_D2.5mm_P2.54mm_Vertical
R707, R708, R709, R710, R711, R712, R720: 100k; R_Axial_DIN0207_L6.3mm_D2.5mm_P7.62mm_Horizontal
R714, R719: 22k; R_Axial_DIN0207_L6.3mm_D2.5mm_P7.62mm_Horizontal
R715: 470k; R_Axial_DIN0207_L6.3mm_D2.5mm_P7.62mm_Horizontal
R716: 560; R_Axial_DIN0207_L6.3mm_D2.5mm_P7.62mm_Horizontal
R717: 47k; R_Axial_DIN0207_L6.3mm_D2.5mm_P7.62mm_Horizontal
R718: 4k7; R_Axial_DIN0207_L6.3mm_D2.5mm_P7.62mm_Horizontal
U701: 40106; DIP-14_W7.62mm
U702: TL072; DIP-8_W7.62mm

Connections:
+5V: U701.14 (VDD)
+12V: R718.2, U702.8 (V+)
-12V: U702.4 (V-)
GND: C701.2, C702.2, C703.2, C704.2, C705.2, C706.2, C710.2, Q702.3 (E), R716.1, U701.7 (VSS), U702.3 (+), U702.5 (+)
Metallic: C709.1, R715.2, U702.1
unnamed: C701.1, R701.2, U701.1
unnamed: C702.1, R702.2, U701.3
unnamed: C703.1, R703.2, U701.5
unnamed: C704.1, R704.2, U701.9
unnamed: C705.1, R705.2, U701.11
unnamed: C706.1, R706.2, U701.13
unnamed: C707.1, R714.2
unnamed: C707.2, R707.1, R708.1, R709.1, R710.1, R711.1, R712.1
unnamed: C708.1, C709.2, R716.2
unnamed: C708.2, R714.1, R715.1, U702.2 (-)
unnamed: C710.1, Q701.3 (E), R717.2
unnamed: C711.1, R719.2
unnamed: C711.2, Q702.1 (C), R717.1, R718.1
unnamed: Q701.2 (B), Q702.2 (B)
unnamed: R701.1, R707.2, U701.2
unnamed: R702.1, R708.2, U701.4
unnamed: R703.1, R709.2, U701.6
unnamed: R704.1, R710.2, U701.8
unnamed: R705.1, R711.2, U701.10
unnamed: R706.1, R712.2, U701.12
unnamed: R719.1, R720.2, U702.6 (-)
White: R720.1, U702.7
