hsetlik/ESP808/Schematic/Output.kicad_sch

## KiCad design Schematic/Output.kicad_sch (2023-11-11)

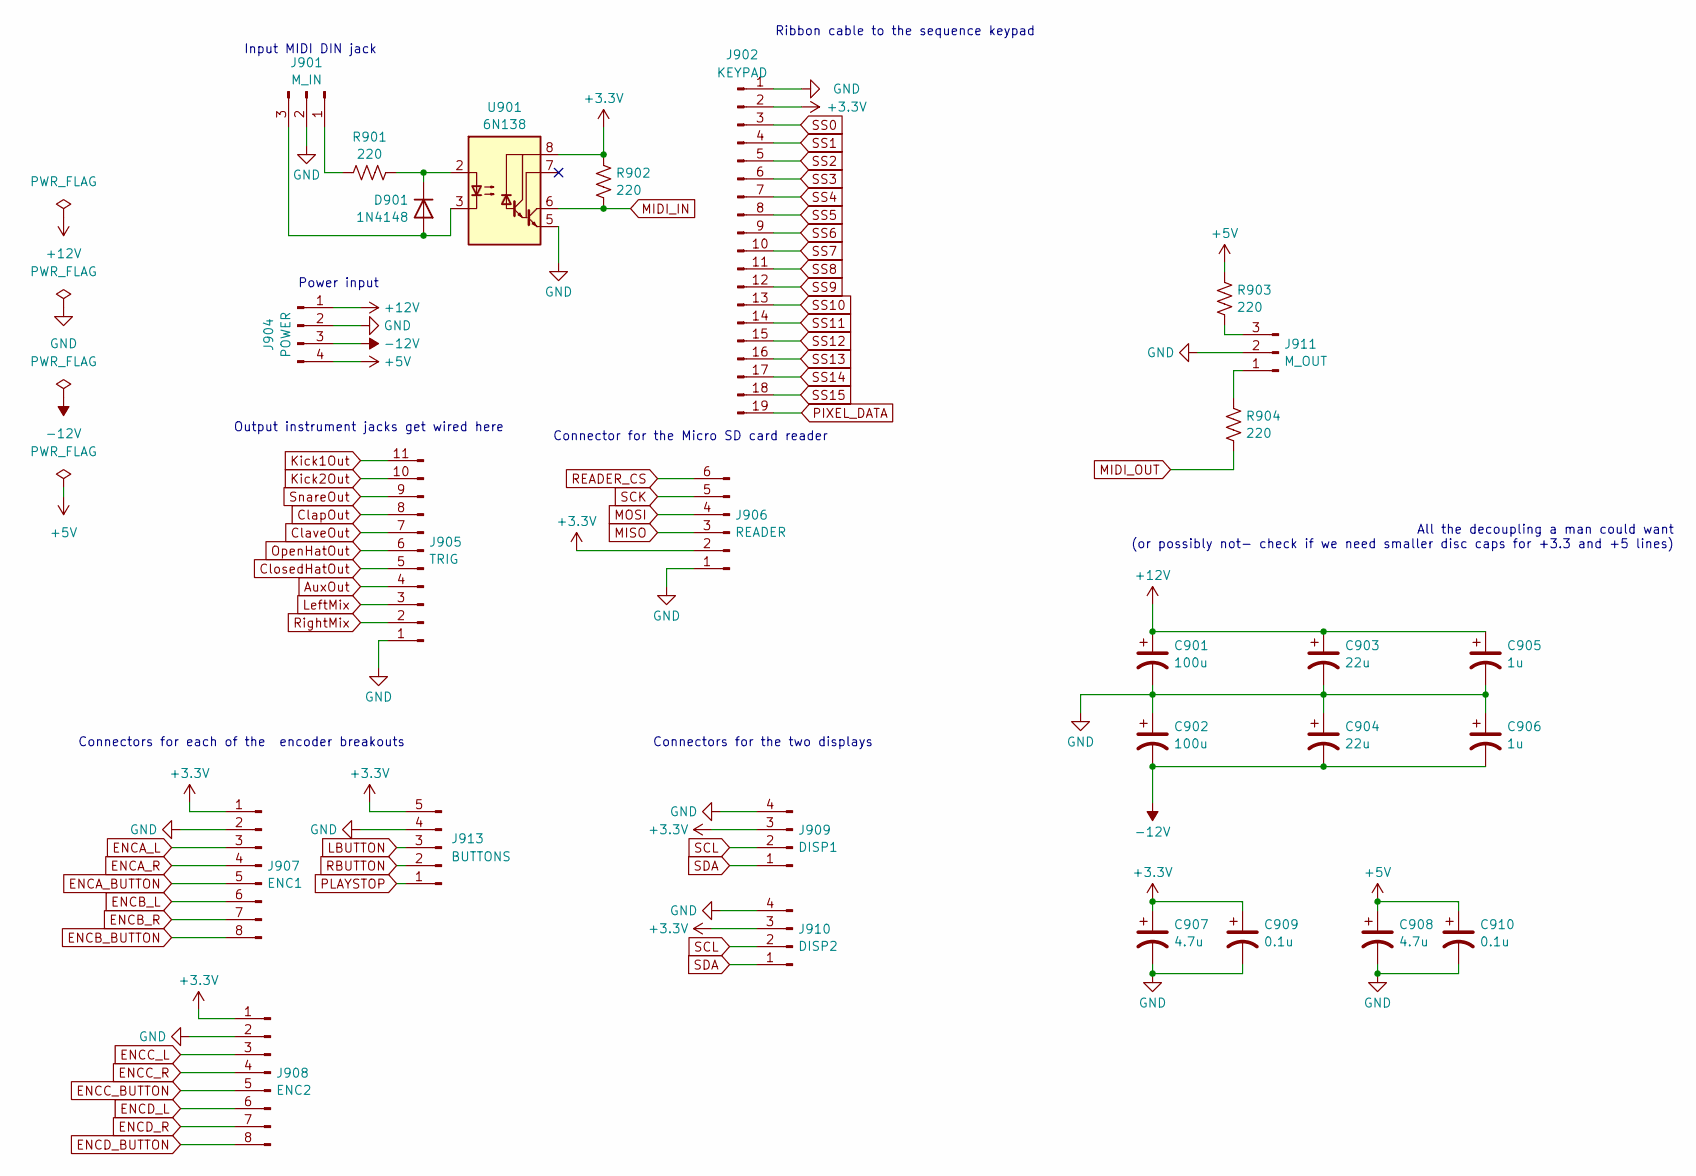
[picture p8: schematic Output.kicad_sch]

Parts:
C901, C902: 100u; CP_Radial_D5.0mm_P2.50mm
C903, C904: 22u; CP_Radial_D5.0mm_P2.50mm
C905, C906: 1u; CP_Radial_D5.0mm_P2.00mm
C907, C908: 4.7u; CP_Radial_D5.0mm_P2.00mm
C909, C910: 0.1u; CP_Radial_D5.0mm_P2.00mm
D901: 1N4148; D_DO-35_SOD27_P7.62mm_Horizontal
J901: M_IN; PinHeader_1x03_P2.54mm_Vertical
J902: KEYPAD; PinHeader_1x19_P2.54mm_Vertical
J904: POWER; PinHeader_1x04_P2.54mm_Vertical
J905: TRIG; PinHeader_1x11_P2.54mm_Vertical
J906: READER; PinHeader_1x06_P2.54mm_Vertical
J907: ENC1; PinHeader_1x08_P2.54mm_Vertical
J908: ENC2; PinHeader_1x08_P2.54mm_Vertical
J909: DISP1; PinHeader_1x04_P2.54mm_Vertical
J910: DISP2; PinHeader_1x04_P2.54mm_Vertical
J911: M_OUT; PinHeader_1x03_P2.54mm_Vertical
J913: BUTTONS; PinHeader_1x05_P2.54mm_Vertical
R901, R902, R903, R904: 220; R_Axial_DIN0207_L6.3mm_D2.5mm_P7.62mm_Horizontal
U901: 6N138; DIP-8_W7.62mm

Connections:
+3.3V: C907.1, C909.1, J902.2, J906.2, J907.1, J908.1, J909.3, J910.3, J913.5, R902.2, U901.8 (VCC)
+5V: C908.1, C910.1, J904.4, R903.2
+12V: C901.1, C903.1, C905.1, J904.1
-12V: C902.2, C904.2, C906.2, J904.3
AuxOut: J905.4
ClapOut: J905.8
ClaveOut: J905.7
ClosedHatOut: J905.5
ENCA_BUTTON: J907.5
ENCA_L: J907.3
ENCA_R: J907.4
ENCB_BUTTON: J907.8
ENCB_L: J907.6
ENCB_R: J907.7
ENCC_BUTTON: J908.5
ENCC_L: J908.3
ENCC_R: J908.4
ENCD_BUTTON: J908.8
ENCD_L: J908.6
ENCD_R: J908.7
GND: C901.2, C902.1, C903.2, C904.1, C905.2, C906.1, C907.2, C908.2, C909.2, C910.2, J901.2, J902.1, J904.2, J905.1, J906.1, J907.2, J908.2, J909.4, J910.4, J911.2, J913.4, U901.5 (GND)
Kick1Out: J905.11
Kick2Out: J905.10
LBUTTON: J913.3
LeftMix: J905.3
MIDI_IN: R902.1, U901.6 (VO2)
MIDI_OUT: R904.1
MISO: J906.3
MOSI: J906.4
unnamed: D901.1 (K), R901.2, U901.2 (C1)
unnamed: D901.2 (A), J901.3, U901.3 (C2)
unnamed: J901.1, R901.1
unnamed: J911.1, R904.2
unnamed: J911.3, R903.1
OpenHatOut: J905.6
PIXEL_DATA: J902.19
PLAYSTOP: J913.1
RBUTTON: J913.2
READER_CS: J906.6
RightMix: J905.2
SCK: J906.5
SCL: J909.2, J910.2
SDA: J909.1, J910.1
SS0: J902.3
SS1: J902.4
SS2: J902.5
SS3: J902.6
SS4: J902.7
SS5: J902.8
SS6: J902.9
SS7: J902.10
SS8: J902.11
SS9: J902.12
SS10: J902.13
SS11: J902.14
SS12: J902.15
SS13: J902.16
SS14: J902.17
SS15: J902.18
SnareOut: J905.9

Notes on the sheet:
Ribbon cable to the sequence keypad
Input MIDI DIN jack
Output instrument jacks get wired here
All the decoupling a man could want (or possibly not- check if we need smaller disc caps for +3.3 and +5 lines)
Connectors for each of the encoder breakouts
Connector for the Micro SD card reader
Connectors for the two displays
Power input
