hsetlik/ESP808/Schematic/Snare.kicad_sch

## KiCad design Schematic/Snare.kicad_sch (2023-11-11)

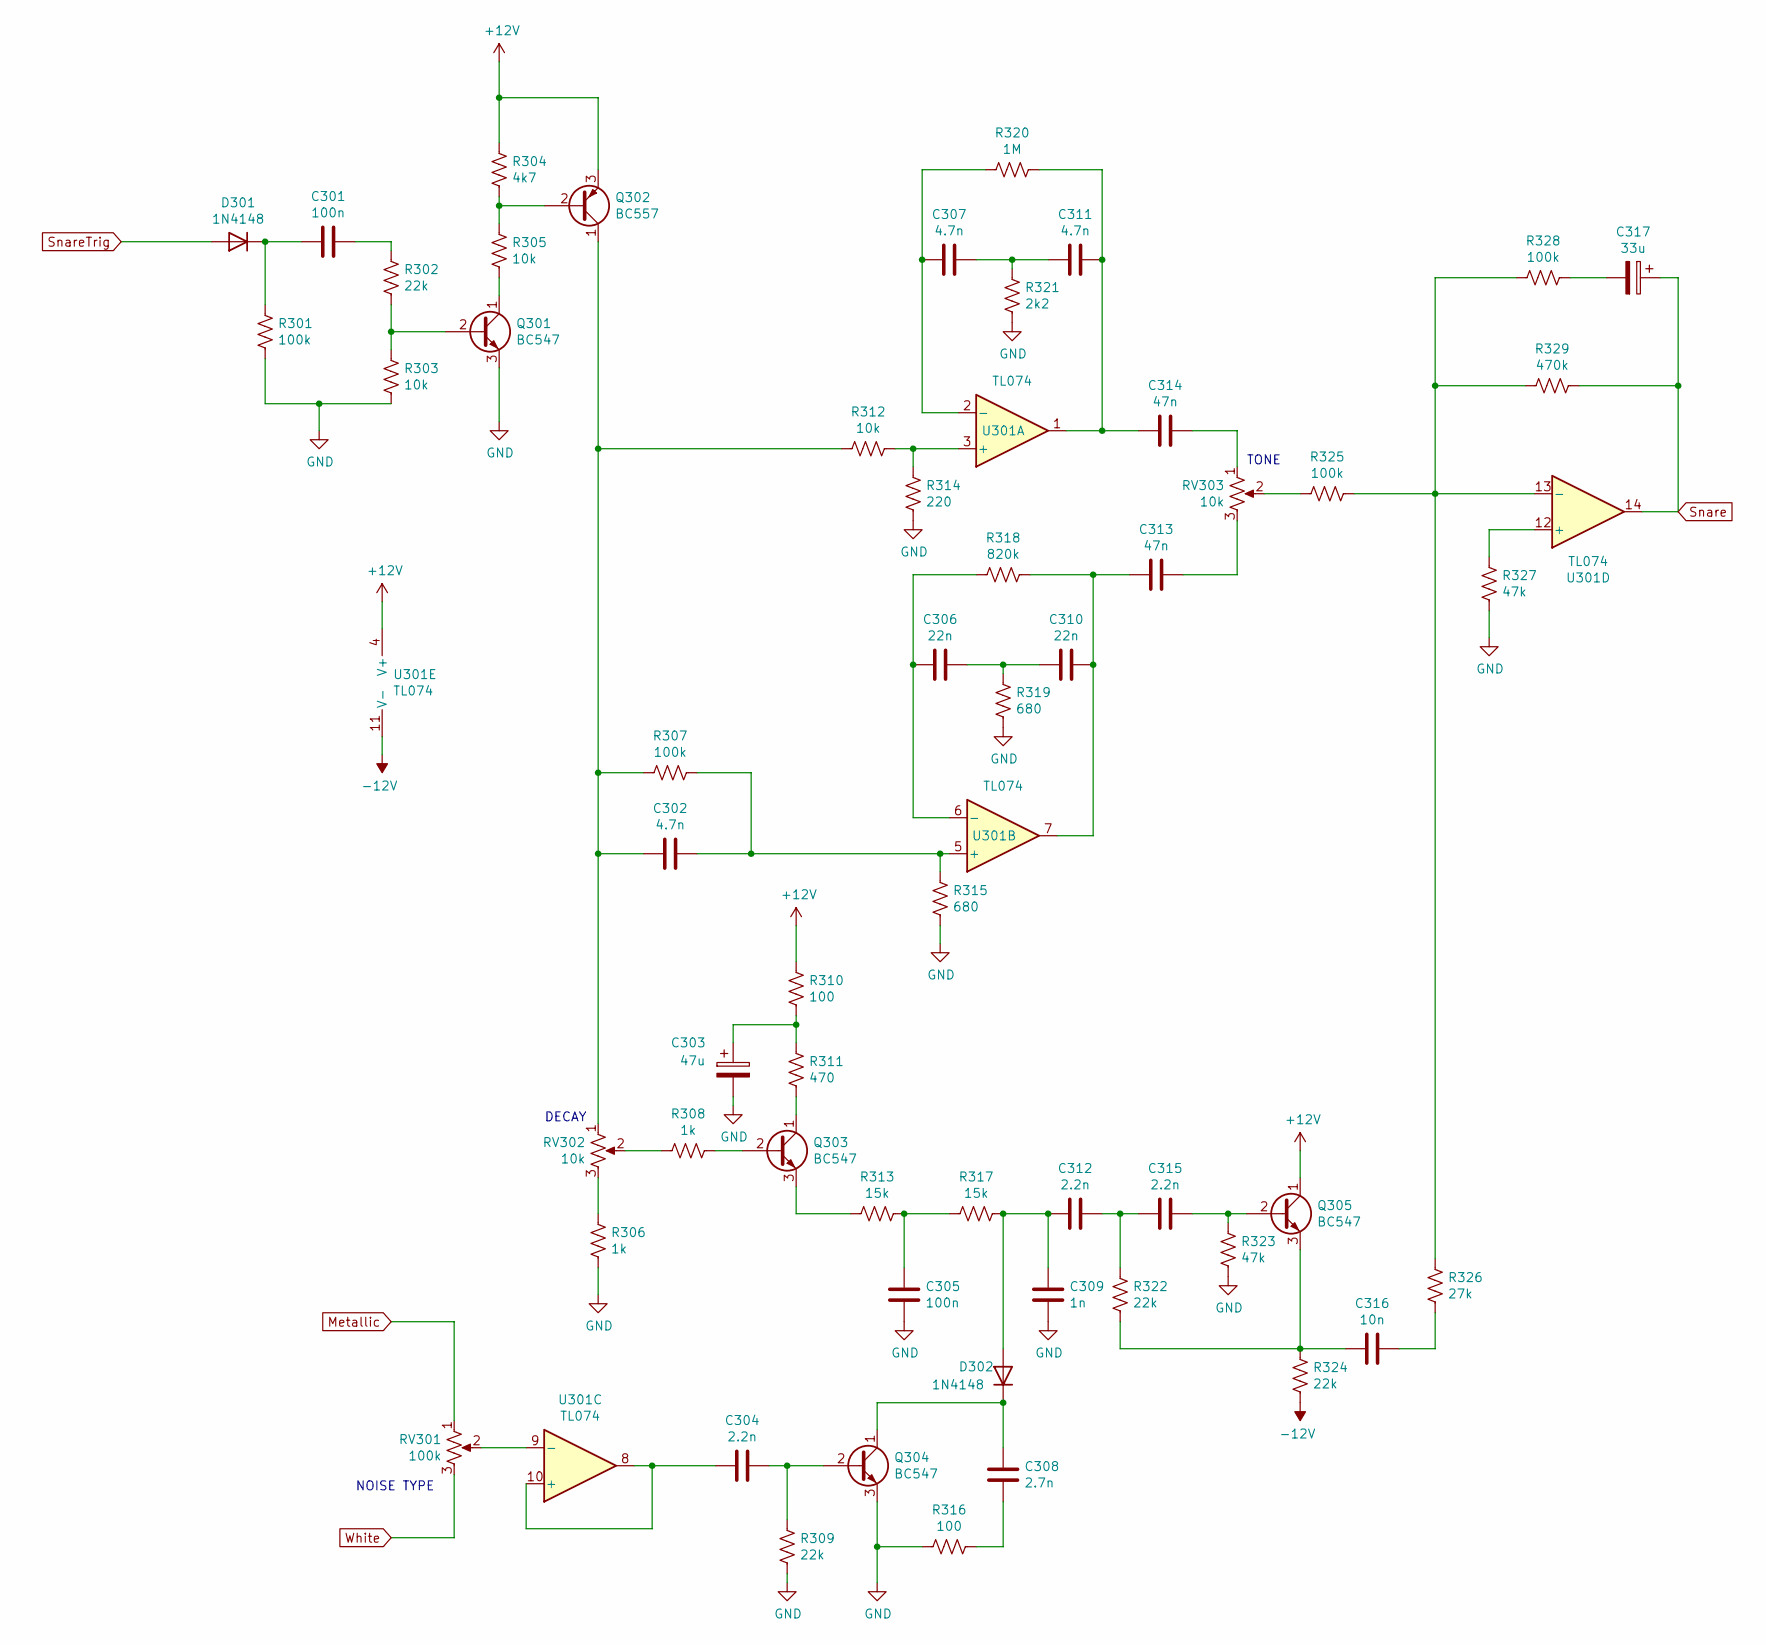
[picture p9: schematic Snare.kicad_sch]

Parts:
C301, C305: 100n; C_Disc_D4.7mm_W2.5mm_P5.00mm
C302, C307, C311: 4.7n; C_Disc_D4.7mm_W2.5mm_P5.00mm
C303: 47u; CP_Radial_D6.3mm_P2.50mm
C304, C312, C315: 2.2n; C_Disc_D4.7mm_W2.5mm_P5.00mm
C306, C310: 22n; C_Disc_D4.7mm_W2.5mm_P5.00mm
C308: 2.7n; C_Disc_D4.7mm_W2.5mm_P5.00mm
C309: 1n; C_Disc_D4.7mm_W2.5mm_P5.00mm
C313, C314: 47n; C_Disc_D4.7mm_W2.5mm_P5.00mm
C316: 10n; C_Disc_D4.7mm_W2.5mm_P5.00mm
C317: 33u; CP_Radial_D6.3mm_P2.50mm
D301, D302: 1N4148; D_DO-35_SOD27_P7.62mm_Horizontal
Q301, Q303, Q304, Q305: BC547; TO-92L_HandSolder
Q302: BC557; TO-92L_HandSolder
R301, R307, R325, R328: 100k; R_Axial_DIN0207_L6.3mm_D2.5mm_P7.62mm_Horizontal
R302, R309, R322, R324: 22k; R_Axial_DIN0207_L6.3mm_D2.5mm_P7.62mm_Horizontal
R303, R305, R312: 10k; R_Axial_DIN0207_L6.3mm_D2.5mm_P7.62mm_Horizontal
R304: 4k7; R_Axial_DIN0207_L6.3mm_D2.5mm_P7.62mm_Horizontal
R306, R308: 1k; R_Axial_DIN0207_L6.3mm_D2.5mm_P7.62mm_Horizontal
R310, R316: 100; R_Axial_DIN0207_L6.3mm_D2.5mm_P7.62mm_Horizontal
R311: 470; R_Axial_DIN0207_L6.3mm_D2.5mm_P7.62mm_Horizontal
R313, R317: 15k; R_Axial_DIN0207_L6.3mm_D2.5mm_P7.62mm_Horizontal
R314: 220; R_Axial_DIN0207_L6.3mm_D2.5mm_P7.62mm_Horizontal
R315, R319: 680; R_Axial_DIN0207_L6.3mm_D2.5mm_P7.62mm_Horizontal
R318: 820k; R_Axial_DIN0207_L6.3mm_D2.5mm_P7.62mm_Horizontal
R320: 1M; R_Axial_DIN0207_L6.3mm_D2.5mm_P7.62mm_Horizontal
R321: 2k2; R_Axial_DIN0207_L6.3mm_D2.5mm_P7.62mm_Horizontal
R323, R327: 47k; R_Axial_DIN0207_L6.3mm_D2.5mm_P7.62mm_Horizontal
R326: 27k; R_Axial_DIN0207_L6.3mm_D2.5mm_P7.62mm_Horizontal
R329: 470k; R_Axial_DIN0207_L6.3mm_D2.5mm_P7.62mm_Horizontal
RV301: 100k; PinHeader_1x03_P2.54mm_Vertical
RV302, RV303: 10k; PinHeader_1x03_P2.54mm_Vertical
U301: TL074; DIP-14_W7.62mm

Connections:
+12V: Q302.3 (E), Q305.1 (C), R304.1, R310.1, U301.4 (V+)
-12V: R324.1, U301.11 (V-)
GND: C303.2, C305.1, C309.1, Q301.3 (E), Q304.3 (E), R301.2, R303.2, R306.2, R309.2, R314.1, R315.2, R316.2, R319.2, R321.2, R323.1, R327.2
Metallic: RV301.1
unnamed: C301.1, R302.1
unnamed: C301.2, D301.1 (K), R301.1
unnamed: C302.1, R307.1, R315.1, U301.5 (+)
unnamed: C302.2, Q302.1 (C), R307.2, R312.2, RV302.1
unnamed: C303.1, R310.2, R311.1
unnamed: C304.1, Q304.2 (B), R309.1
unnamed: C304.2, U301.8, U301.10 (+)
unnamed: C305.2, R313.1, R317.2
unnamed: C306.1, C310.2, R319.1
unnamed: C306.2, R318.2, U301.6 (-)
unnamed: C307.1, C311.2, R321.1
unnamed: C307.2, R320.2, U301.2 (-)
unnamed: C308.1, R316.1
unnamed: C308.2, D302.1 (K), Q304.1 (C)
unnamed: C309.2, C312.2, D302.2 (A), R317.1
unnamed: C310.1, C313.2, R318.1, U301.7
unnamed: C311.1, C314.2, R320.1, U301.1
unnamed: C312.1, C315.2, R322.2
unnamed: C313.1, RV303.3
unnamed: C314.1, RV303.1
unnamed: C315.1, Q305.2 (B), R323.2
unnamed: C316.1, R326.1
unnamed: C316.2, Q305.3 (E), R322.1, R324.2
unnamed: C317.2, R328.1
unnamed: Q301.1 (C), R305.2
unnamed: Q301.2 (B), R302.2, R303.1
unnamed: Q302.2 (B), R304.2, R305.1
unnamed: Q303.1 (C), R311.2
unnamed: Q303.2 (B), R308.1
unnamed: Q303.3 (E), R313.2
unnamed: R306.1, RV302.3
unnamed: R308.2, RV302.2
unnamed: R312.1, R314.2, U301.3 (+)
unnamed: R325.1, R326.2, R328.2, R329.2, U301.13 (-)
unnamed: R325.2, RV303.2
unnamed: R327.1, U301.12 (+)
unnamed: RV301.2, U301.9 (-)
Snare: C317.1, R329.1, U301.14
SnareTrig: D301.2 (A)
White: RV301.3

Notes on the sheet:
NOISE TYPE
TONE
DECAY
