hsetlik/ESP808/(commit log)

2023-09-09 added schematics to git
    [Clap.kicad_sch, Clap.sch, Clave.kicad_sch, Clave.sch, Digital.kicad_sch, Digital.sch, ESP808.csv, ESP808.kicad_sch]
2023-11-11 cleansing fire
    [Digital.kicad_sch, ESP808.csv, HiHat.kicad_sch, Kicks.kicad_sch, Mixer.kicad_sch, Output.kicad_sch, Snare.kicad_sch]
2023-11-16 more display handling
    [Digital.kicad_sch]
2023-11-19 buttons and SPI stuff
2023-11-20 buttons, colors
2023-11-20 basic LED rendering
2023-11-20 callback wiring stuff
2023-11-26 button debugging :(
